merledu/azadi-soc/verif/random_tests/asm/extras/README.md

These tests were run on the core while simulating Azadi SoC's powered netlist
