merledu/azadi-soc/(threads)

Thread 3 (2021-09-10):

More multiple conflicting drivers

zainrizwankhan, 2021-09-10:
Continuing from #1 the signal `fp_dst_fmt_o` has been assigned a value here as well as in an `always_comb` block further down the code. This gives the following error, again, on Xcelium.

```
xmelab: *E,MULDRN (/home/zrkhan/Desktop/uvm-runs/azadi-new/hw/vendor/lowrisc_ibex/rtl/ibex_core.sv,860|13): Variable 'core_ibex_tb_top.dut.u_ibex_core.fp_load' has multiple conflicting drivers and the indicated output port connection in scope 'core_ibex_tb_top.dut.u_ibex_core' is contributing to this conflict set.
  assign fp_dst_fmt_o = FP32;
                      |
```

Closed 2021-09-10.
