merledu/azadi-soc/(list of files, drawings)

Other design files:
flash_model/N25Q128A13E_VG12/sim/waves.shm/waves.dsn
