merledu/azadi-soc/sub/rv_plic/src/rv_plic_reg_top.sv

// Copyright lowRISC contributors.
// Licensed under the Apache License, Version 2.0, see LICENSE for details.
// SPDX-License-Identifier: Apache-2.0
//
// Modified by MERL, for Azadi SoC

module rv_plic_reg_top import rv_plic_reg_pkg::*; (
  input logic clk_i,
  input logic rst_ni,

  // Below Regster interface can be changed
  input  tlul_pkg::tlul_h2d_t tl_i,
  output tlul_pkg::tlul_d2h_t tl_o,
  // To HW
  output rv_plic_reg_pkg::rv_plic_reg2hw_t reg2hw, // Write
  input  rv_plic_reg_pkg::rv_plic_hw2reg_t hw2reg, // Read

  // Config
  input devmode_i // If 1, explicit error return for unmapped register access
);

  localparam int AW = 10;
  localparam int DW = 32;
  localparam int DBW = DW/8; // Byte Width

  // register signals
  logic           reg_we;
  logic           reg_re;
  logic [AW-1:0]  reg_addr;
  logic [DW-1:0]  reg_wdata;
  logic [DBW-1:0] reg_be;
  logic [DW-1:0]  reg_rdata;
  logic           reg_error;

  logic           addrmiss, wr_err;

  logic [DW-1:0]  reg_rdata_next;

  tlul_pkg::tlul_h2d_t tl_reg_h2d;
  tlul_pkg::tlul_d2h_t tl_reg_d2h;

  assign tl_reg_h2d = tl_i;
  assign tl_o       = tl_reg_d2h;

  tlul_adapter_reg #(
    .RegAw(AW),
    .RegDw(DW)
  ) u_reg_if (
    .clk_i,
    .rst_ni,

    .tl_i (tl_reg_h2d),
    .tl_o (tl_reg_d2h),

    .we_o    (reg_we),
    .re_o    (reg_re),
    .addr_o  (reg_addr),
    .wdata_o (reg_wdata),
    .be_o    (reg_be),
    .rdata_i (reg_rdata),
    .error_i (reg_error)
  );

  assign reg_rdata = reg_rdata_next ;
  assign reg_error = (devmode_i & addrmiss) | wr_err ;

  // Define SW related signals
  // Format: <reg>_<field>_{wd|we|qs}
  //        or <reg>_{wd|we|qs} if field == 1 or 0
  logic ip_0_p_0_qs;
  logic ip_0_p_1_qs;
  logic ip_0_p_2_qs;
  logic ip_0_p_3_qs;
  logic ip_0_p_4_qs;
  logic ip_0_p_5_qs;
  logic ip_0_p_6_qs;
  logic ip_0_p_7_qs;
  logic ip_0_p_8_qs;
  logic ip_0_p_9_qs;
  logic ip_0_p_10_qs;
  logic ip_0_p_11_qs;
  logic ip_0_p_12_qs;
  logic ip_0_p_13_qs;
  logic ip_0_p_14_qs;
  logic ip_0_p_15_qs;
  logic ip_0_p_16_qs;
  logic ip_0_p_17_qs;
  logic ip_0_p_18_qs;
  logic ip_0_p_19_qs;
  logic ip_0_p_20_qs;
  logic ip_0_p_21_qs;
  logic ip_0_p_22_qs;
  logic ip_0_p_23_qs;
  logic ip_0_p_24_qs;
  logic ip_0_p_25_qs;
  logic ip_0_p_26_qs;
  logic ip_0_p_27_qs;
  logic ip_0_p_28_qs;
  logic ip_0_p_29_qs;
  logic ip_0_p_30_qs;
  logic ip_0_p_31_qs;
  logic ip_1_p_32_qs;
  logic ip_1_p_33_qs;
  logic ip_1_p_34_qs;
  logic ip_1_p_35_qs;
  logic ip_1_p_36_qs;
  logic ip_1_p_37_qs;
  logic ip_1_p_38_qs;
  logic ip_1_p_39_qs;
  logic ip_1_p_40_qs;
  logic ip_1_p_41_qs;
  logic ip_1_p_42_qs;
  logic ip_1_p_43_qs;
  logic ip_1_p_44_qs;
  logic ip_1_p_45_qs;
  logic ip_1_p_46_qs;
  logic ip_1_p_47_qs;
  logic ip_1_p_48_qs;

  logic le_0_le_0_qs;
  logic le_0_le_0_wd;
  logic le_0_le_0_we;
  logic le_0_le_1_qs;
  logic le_0_le_1_wd;
  logic le_0_le_1_we;
  logic le_0_le_2_qs;
  logic le_0_le_2_wd;
  logic le_0_le_2_we;
  logic le_0_le_3_qs;
  logic le_0_le_3_wd;
  logic le_0_le_3_we;
  logic le_0_le_4_qs;
  logic le_0_le_4_wd;
  logic le_0_le_4_we;
  logic le_0_le_5_qs;
  logic le_0_le_5_wd;
  logic le_0_le_5_we;
  logic le_0_le_6_qs;
  logic le_0_le_6_wd;
  logic le_0_le_6_we;
  logic le_0_le_7_qs;
  logic le_0_le_7_wd;
  logic le_0_le_7_we;
  logic le_0_le_8_qs;
  logic le_0_le_8_wd;
  logic le_0_le_8_we;
  logic le_0_le_9_qs;
  logic le_0_le_9_wd;
  logic le_0_le_9_we;
  logic le_0_le_10_qs;
  logic le_0_le_10_wd;
  logic le_0_le_10_we;
  logic le_0_le_11_qs;
  logic le_0_le_11_wd;
  logic le_0_le_11_we;
  logic le_0_le_12_qs;
  logic le_0_le_12_wd;
  logic le_0_le_12_we;
  logic le_0_le_13_qs;
  logic le_0_le_13_wd;
  logic le_0_le_13_we;
  logic le_0_le_14_qs;
  logic le_0_le_14_wd;
  logic le_0_le_14_we;
  logic le_0_le_15_qs;
  logic le_0_le_15_wd;
  logic le_0_le_15_we;
  logic le_0_le_16_qs;
  logic le_0_le_16_wd;
  logic le_0_le_16_we;
  logic le_0_le_17_qs;
  logic le_0_le_17_wd;
  logic le_0_le_17_we;
  logic le_0_le_18_qs;
  logic le_0_le_18_wd;
  logic le_0_le_18_we;
  logic le_0_le_19_qs;
  logic le_0_le_19_wd;
  logic le_0_le_19_we;
  logic le_0_le_20_qs;
  logic le_0_le_20_wd;
  logic le_0_le_20_we;
  logic le_0_le_21_qs;
  logic le_0_le_21_wd;
  logic le_0_le_21_we;
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
    .clk_i   (clk_i   ),
    .rst_ni  (rst_ni  ),

    // from register interface
    .we     (ie0_1_e_44_we),
    .wd     (ie0_1_e_44_wd),

    // from internal hardware
    .de     (1'b0),
    .d      ('0  ),

    // to internal hardware
    .qe     (),
    .q      (reg2hw.ie0[44].q ),

    // to register interface (read)
    .qs     (ie0_1_e_44_qs)
  );

  prim_subreg #(
    .DW      (1),
    .SWACCESS("RW"),
    .RESVAL  (1'h0)
  ) u_ie0_1_e_45 (
    .clk_i   (clk_i   ),
    .rst_ni  (rst_ni  ),

    // from register interface
    .we     (ie0_1_e_45_we),
    .wd     (ie0_1_e_45_wd),

    // from internal hardware
    .de     (1'b0),
    .d      ('0  ),

    // to internal hardware
    .qe     (),
    .q      (reg2hw.ie0[45].q ),

    // to register interface (read)
    .qs     (ie0_1_e_45_qs)
  );

  prim_subreg #(
    .DW      (1),
    .SWACCESS("RW"),
    .RESVAL  (1'h0)
  ) u_ie0_1_e_46 (
    .clk_i   (clk_i   ),
    .rst_ni  (rst_ni  ),

    // from register interface
    .we     (ie0_1_e_46_we),
    .wd     (ie0_1_e_46_wd),

    // from internal hardware
    .de     (1'b0),
    .d      ('0  ),

    // to internal hardware
    .qe     (),
    .q      (reg2hw.ie0[46].q ),

    // to register interface (read)
    .qs     (ie0_1_e_46_qs)
  );

  prim_subreg #(
    .DW      (1),
    .SWACCESS("RW"),
    .RESVAL  (1'h0)
  ) u_ie0_1_e_47 (
    .clk_i   (clk_i   ),
    .rst_ni  (rst_ni  ),

    // from register interface
    .we     (ie0_1_e_47_we),
    .wd     (ie0_1_e_47_wd),

    // from internal hardware
    .de     (1'b0),
    .d      ('0  ),

    // to internal hardware
    .qe     (),
    .q      (reg2hw.ie0[47].q ),

    // to register interface (read)
    .qs     (ie0_1_e_47_qs)
  );

  prim_subreg #(
    .DW      (1),
    .SWACCESS("RW"),
    .RESVAL  (1'h0)
  ) u_ie0_1_e_48 (
    .clk_i   (clk_i   ),
    .rst_ni  (rst_ni  ),

    // from register interface
    .we     (ie0_1_e_48_we),
    .wd     (ie0_1_e_48_wd),

    // from internal hardware
    .de     (1'b0),
    .d      ('0  ),

    // to internal hardware
    .qe     (),
    .q      (reg2hw.ie0[48].q ),

    // to register interface (read)
    .qs     (ie0_1_e_48_qs)
  );

  // R[threshold0]: V(False)
  prim_subreg #(
    .DW      (2),
    .SWACCESS("RW"),
    .RESVAL  (2'h0)
  ) u_threshold0 (
    .clk_i   (clk_i   ),
    .rst_ni  (rst_ni  ),

    // from register interface
    .we     (threshold0_we),
    .wd     (threshold0_wd),

    // from internal hardware
    .de     (1'b0),
    .d      ('0  ),

    // to internal hardware
    .qe     (),
    .q      (reg2hw.threshold0.q ),

    // to register interface (read)
    .qs     (threshold0_qs)
  );

  // R[cc0]: V(True)
  prim_subreg_ext #(
    .DW    (6)
  ) u_cc0 (
    .re     (cc0_re),
    .we     (cc0_we),
    .wd     (cc0_wd),
    .d      (hw2reg.cc0.d),
    .qre    (reg2hw.cc0.re),
    .qe     (reg2hw.cc0.qe),
    .q      (reg2hw.cc0.q ),
    .qs     (cc0_qs)
  );

  // R[msip0]: V(False)
  prim_subreg #(
    .DW      (1),
    .SWACCESS("RW"),
    .RESVAL  (1'h0)
  ) u_msip0 (
    .clk_i   (clk_i    ),
    .rst_ni  (rst_ni  ),

    // from register interface
    .we     (msip0_we),
    .wd     (msip0_wd),

    // from internal hardware
    .de     (1'b0),
    .d      ('0  ),

    // to internal hardware
    .qe     (),
    .q      (reg2hw.msip0.q ),

    // to register interface (read)
    .qs     (msip0_qs)
  );

  logic [57:0] addr_hit;
  always_comb begin
    addr_hit = '0;
    addr_hit[  0] = (reg_addr == RV_PLIC_IP_0_OFFSET);
    addr_hit[  1] = (reg_addr == RV_PLIC_IP_1_OFFSET);
    addr_hit[  2] = (reg_addr == RV_PLIC_LE_0_OFFSET);
    addr_hit[  3] = (reg_addr == RV_PLIC_LE_1_OFFSET);
    addr_hit[  4] = (reg_addr == RV_PLIC_PRIO0_OFFSET);
    addr_hit[  5] = (reg_addr == RV_PLIC_PRIO1_OFFSET);
    addr_hit[  6] = (reg_addr == RV_PLIC_PRIO2_OFFSET);
    addr_hit[  7] = (reg_addr == RV_PLIC_PRIO3_OFFSET);
    addr_hit[  8] = (reg_addr == RV_PLIC_PRIO4_OFFSET);
    addr_hit[  9] = (reg_addr == RV_PLIC_PRIO5_OFFSET);
    addr_hit[ 10] = (reg_addr == RV_PLIC_PRIO6_OFFSET);
    addr_hit[ 11] = (reg_addr == RV_PLIC_PRIO7_OFFSET);
    addr_hit[ 12] = (reg_addr == RV_PLIC_PRIO8_OFFSET);
    addr_hit[ 13] = (reg_addr == RV_PLIC_PRIO9_OFFSET);
    addr_hit[ 14] = (reg_addr == RV_PLIC_PRIO10_OFFSET);
    addr_hit[ 15] = (reg_addr == RV_PLIC_PRIO11_OFFSET);
    addr_hit[ 16] = (reg_addr == RV_PLIC_PRIO12_OFFSET);
    addr_hit[ 17] = (reg_addr == RV_PLIC_PRIO13_OFFSET);
    addr_hit[ 18] = (reg_addr == RV_PLIC_PRIO14_OFFSET);
    addr_hit[ 19] = (reg_addr == RV_PLIC_PRIO15_OFFSET);
    addr_hit[ 20] = (reg_addr == RV_PLIC_PRIO16_OFFSET);
    addr_hit[ 21] = (reg_addr == RV_PLIC_PRIO17_OFFSET);
    addr_hit[ 22] = (reg_addr == RV_PLIC_PRIO18_OFFSET);
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
  assign ie0_0_e_26_we = addr_hit[53] & reg_we & ~wr_err;
  assign ie0_0_e_26_wd = reg_wdata[26];

  assign ie0_0_e_27_we = addr_hit[53] & reg_we & ~wr_err;
  assign ie0_0_e_27_wd = reg_wdata[27];

  assign ie0_0_e_28_we = addr_hit[53] & reg_we & ~wr_err;
  assign ie0_0_e_28_wd = reg_wdata[28];
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
