merledu/azadi-soc/sub/uart/src/uart_buff_ctrl.sv

module buffer_control #(
  parameter int BUFFER_DEPTH = 128,
  parameter int BUFFER_WIDTH = 8,
  parameter int ADDR_WIDTH   = 8
)(
  input logic clk_i,
  input logic rst_ni,
  
  input logic re_i,
  input logic we_i,
  input logic clr_i,
  input logic rst_i, 
  input logic [BUFFER_WIDTH-1:0] wdata_i,
  
  output logic buffer_full,
  output logic [BUFFER_WIDTH:0] rdata_o,
  output logic                  buffer_empty,
  output logic [ADDR_WIDTH-1:0] bsize_o
);
  
  logic [ADDR_WIDTH:0] raddr;
  logic [ADDR_WIDTH:0] waddr;
  logic msb_comp;
  logic pointer_equal;
  logic fifo_web;
  logic fifo_cen;
  logic [6:0] fifo_addr;
  logic [8:0] rdata;
  
  // write address
  always_ff @ (posedge clk_i or negedge rst_ni) begin
    if(~rst_ni) begin
      waddr <= '0;
    end else begin
      if(clr_i) begin
	      waddr <= '0;
      end else if(we_i && ~buffer_full) begin
	      waddr <= waddr + 1;
      end
    end
   end

  // read adderss
  always_ff @ (posedge clk_i or negedge rst_ni) begin
    if(!rst_ni) begin
      raddr <= '0;
    end else begin 
      if(clr_i) begin
	      raddr <= '0;
      end else if (re_i & (~buffer_empty)) begin
	      raddr <= raddr + 1;
      end
    end
  end

  always_ff @ (posedge clk_i or negedge rst_ni) begin
    if(!rst_ni) begin
      buffer_full <= 1'b0;
    end else begin 
      if(clr_i) begin
	      buffer_full <= 1'b0;
      end else if((waddr >= 8'h7f) & we_i) begin
	      buffer_full <= 1'b1;
      end else if(raddr > 8'h00) begin
	      buffer_full <= 1'b0;
      end
    end
  end
  
  always_ff @ (posedge clk_i or negedge rst_ni) begin
    if(!rst_ni) begin
      buffer_empty <= 1'b0;
    end else begin
      if(clr_i) begin
	      buffer_empty <= 1'b0;
      end else if((raddr >= 8'h7f) & re_i) begin
	      buffer_empty <= 1'b1;
      end 
    end
  end

 sram_fifo fifo(
  .Q	  (rdata), 
  .CLK	(clk_i), 
  .CEN	(fifo_cen), 
  .WEN	(fifo_web), 
  .A	  (fifo_addr), 
  .D	  ({wdata_i, 1'b1}),
  .EMA	('0), 
  .RETN	('1)
 );

  assign fifo_web  = ((re_i && (~buffer_empty)) ? 1'b1 : (we_i && (~buffer_full)) ? 1'b0 : 1'b0 );
  assign fifo_addr = ({7{re_i}} & raddr) | ({7{we_i}} & waddr[6:0]);
  assign fifo_cen  = (we_i ? 1'b0 : re_i ? 1'b0 : 1'b1);
  assign rdata_o   = (raddr <= 8'h7f) ? rdata : '0 ;
  assign bsize_o   =  waddr;
  
endmodule 
