merledu/azadi-soc/sub/uart/src/uart_top.sv

// Copyright lowRISC contributors.
// Licensed under the Apache License, Version 2.0, see LICENSE for details.
// SPDX-License-Identifier: Apache-2.0
//
// Description: UART top level wrapper file

// `include "prim_assert.sv"

module uart_top (
    input logic clk_i,
    input logic rst_ni,

  // Bus Interface
    input  tlul_pkg::tlul_h2d_t tl_i,
    output tlul_pkg::tlul_d2h_t tl_o,
   
    output logic tx_o,
    output logic tx_oe,
    input  logic rx_i,
    
    output logic intr_tx,
    output logic intr_rx
);
    
    logic [31:0] wdata;
    logic [7:0] addr;
    logic        we;
    logic        re;
    logic [31:0] rdata;
    logic [3:0]  be;
    
uart_core u_uart_core(
    .clk_i   (clk_i),
    .rst_ni  (rst_ni),
    
    .ren     (re),
    .we      (we),
    .wdata   (wdata),
    .rdata   (rdata),
    .addr    (addr),    
    .tx_o    (tx_o),
    .tx_oe   (tx_oe),
    .rx_i    (rx_i),
    
    .intr_tx (intr_tx),
    .intr_rx (intr_rx)
);

    
 tlul_adapter_reg #(
    .RegAw(8),
    .RegDw(32)
 ) u_reg_if (
   .clk_i,
   .rst_ni,
    
   .tl_i (tl_i),
   .tl_o (tl_o),
    
   .we_o    (we),
   .re_o    (re),
   .addr_o  (addr),
   .wdata_o (wdata),
   .be_o    (be),
   .rdata_i (rdata),
   .error_i (1'b0)
);
endmodule
