merledu/azadi-soc/flash_model/N25Q128A13E_VG12/code/N25Qxxx.v

//-MICRON--MICRON--MICRON--MICRON--MICRON--MICRON--MICRON--MICRON--MICRON--MICRON--MICRON-
//-MICRON--MICRON--MICRON--MICRON--MICRON--MICRON--MICRON--MICRON--MICRON--MICRON--MICRON-
//-MICRON--MICRON--MICRON--MICRON--MICRON--MICRON--MICRON--MICRON--MICRON--MICRON--MICRON-
//
//  N25Qxxx
//
//  Verilog Behavioral Model
//  Version 1.2
//
//  Copyright (c) 2013 Micron Inc.
//
//-MICRON--MICRON--MICRON--MICRON--MICRON--MICRON--MICRON--MICRON--MICRON--MICRON--MICRON-
//-MICRON--MICRON--MICRON--MICRON--MICRON--MICRON--MICRON--MICRON--MICRON--MICRON--MICRON-
//-MICRON--MICRON--MICRON--MICRON--MICRON--MICRON--MICRON--MICRON--MICRON--MICRON--MICRON-
// Confidential:
// -------------
// This file and all files delivered herewith are Micron Confidential Information.
// 
// 
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
// Copyright 2013 Micron Technology, Inc. All rights reserved.
//
`timescale 1ns / 1ps

/*~~~~~~~~~~~~~~~~~~~~~~~~~~~~~~~~~~~~~~~~~~~~~~~~~~~~~~~~~
-----------------------------------------------------------
-----------------------------------------------------------
--                                                       --
--           TOP LEVEL MODULE                            --
--                                                       --
-----------------------------------------------------------
-----------------------------------------------------------
~~~~~~~~~~~~~~~~~~~~~~~~~~~~~~~~~~~~~~~~~~~~~~~~~~~~~~~~~*/



`include "include/UserData.h"

module paramConfig();
`include "include/DevParam.h"

endmodule


//***********************************************************************
//***********************************************************************
//    N25Q device as stand alone
//***********************************************************************
//***********************************************************************

`ifdef Feature_8
    `ifdef HOLD_pin
        module N25Qxxx (S, C_, HOLD_DQ3, DQ0, DQ1, Vcc, Vpp_W_DQ2, RESET2);
    `elsif RESET_pin 
        module N25Qxxx (S, C_, RESET_DQ3, DQ0, DQ1, Vcc, Vpp_W_DQ2, RESET2);
    `endif
`else    
    `ifdef HOLD_pin
        module N25Qxxx (S, C_, HOLD_DQ3, DQ0, DQ1, Vcc, Vpp_W_DQ2);
    `elsif RESET_pin 
        module N25Qxxx (S, C_, RESET_DQ3, DQ0, DQ1, Vcc, Vpp_W_DQ2);
    `endif
`endif

`include "include/DevParam.h"
 parameter [1:0] rdeasystacken = 0;
 parameter [1:0] rdeasystacken2 = 0;
 parameter [15:0] NVConfigReg_default = `NVCR_DEFAULT_VALUE;
 
`ifdef MEDITERANEO
    `define defaultDummy 6
    `define defaultiDummy 5
`else
    `define defaultDummy 8
    `define defaultiDummy 7
`endif    

input S;
input C_;
input [`VoltageRange] Vcc;

inout DQ0; 
inout DQ1;
//wire RESET;

`ifdef Feature_8
   `ifdef HOLD_pin
        inout HOLD_DQ3; //input HOLD, inout DQ3
        input RESET2;
    `elsif RESET_pin
        inout RESET_DQ3; //input HOLD, inout DQ3
        input RESET2;
    `endif
`else
   `ifdef HOLD_pin
        inout HOLD_DQ3; //input HOLD, inout DQ3
    `elsif RESET_pin
        inout RESET_DQ3; //input HOLD, inout DQ3
    `endif
`endif


inout Vpp_W_DQ2; //input Vpp_W, inout DQ2 (VPPH not implemented)


parameter [40*8:1] memory_file = "mem_Q128_bottom.vmf";

parameter [48*8:1] fdp_file = "sfdp.vmf";


reg PollingAccessOn = 0;
reg ReadAccessOn = 0;
wire WriteAccessOn; 

// indicate type of data that will be latched by the model:
//  C=command, A=address, I= address on two pins; E= address on four pins; D=data, N=none, Y=dummy, F=dual_input(F=fast),Q=Quad_io 
reg [8:1] latchingMode = "N";

reg [8*8:1] protocol="extended";

reg [cmdDim-1:0] cmd='h0;
`ifdef byte_4
  reg [addrDimLatch4-1:0] addrLatch='h0;
`else
  reg [addrDimLatch-1:0] addrLatch='h0;
`endif
reg [addrDim-1:0] addr='h0;
reg [dataDim-1:0] data='h0;
reg [dummyDim-1:0] dummy='h0;
reg [dataDim-1:0] LSdata='h0;
reg [dataDim-1:0] dataOut='h0;

integer dummyDimEff;

reg [40*8:1] cmdRecName;

reg quadMode ='h0;

reg die_active = 'h1;  // Indicates that this die is active
                       // Used for stacked die


buf (strong1, strong0) b0(C, C_);

//----------------------
// Report Model Info 
//----------------------
initial begin
    $display ("==============================================");
    $display ("===INFO=== Model Configuration Info");
    determineDevName;
    `ifdef RESET_pin
        $display ("===INFO=== DQ3 = RESET pin");
    `endif   
    `ifdef HOLD_pin
        $display ("===INFO=== DQ3 = HOLD pin");
    `endif   
    `ifdef XIP_Numonyx 
        $display ("===INFO=== XIP type = Numonyx");
    `endif   
    `ifdef XIP_basic 
        $display ("===INFO=== XIP type = Basic");
    `endif   
    `ifdef VCC_1e8V
        $display ("===INFO=== VCC 1.8V");
    `endif    
    `ifdef VCC_3V
        $display ("===INFO=== VCC 3V");
    `endif   
    $display ("==============================================");
end


//----------------------
// HOLD signal
//----------------------
//dovrebbe essere abilitato attraverso il bit 4 del VECR o anche attraverso il bit 4 del NVECR
reg NVCR_HoldResetEnable;

`ifdef HOLD_pin

    reg intHOLD=1;

//aggiunta verificare
   //latchingMode=="E"                                                                                                                                                                 
    assign HOLD = (read.enable_quad || 
                   quadMode == 1 || 
                   latchingMode=="Q"  || 
                   latchingMode=="E" || 
                   protocol=="quad" || 
                   VolatileEnhReg.VECR[4]==0 || 
                   (NVCR_HoldResetEnable==0 && prog.dummySetByVECR==0))  ? 1 : HOLD_DQ3; //serve per disabilitare la funzione di hold nel caso di quad read


    always @(HOLD) if (S==0 && C==0) 
        intHOLD = HOLD;
    
    always @(negedge C) if(S==0 && intHOLD!=HOLD) 
        intHOLD = HOLD;

    always @(posedge HOLD , posedge S) if(S==1)
        intHOLD = 1;
    
    always @intHOLD if (Vcc>=Vcc_min) begin
        if(intHOLD==0)
            $display("[%0t ns] ==INFO== Hold condition enabled: communication with the device has been paused.", $time);
        else if(intHOLD==1)
            $display("[%0t ns] ==INFO== Hold condition disabled: communication with the device has been activated.", $time);  
   end
`endif



//-------------------------
// Internal signals
//-------------------------

reg busy=0;

reg [2:0] ck_count = 0; //clock counter (modulo 8) 

reg reset_by_powerOn = 1; //reset_by_powerOn is updated in "Power Up & Voltage check" section


`ifdef Feature_8
        assign RESET = ((read.enable_quad || latchingMode=="Q" || quadMode == 1 ||
                        cmdRecName=="Quad Output Read" || cmdRecName=="Quad I/O Fast Read" ||
                        latchingMode=="E" || protocol=="quad" || VolatileEnhReg.VECR[4]==0 ||
                        NVCR_HoldResetEnable==0 || cmdRecName=="Extended command DOFRDTR" || 
                        cmdRecName=="Extended command DIOFRDTR" || cmdRecName=="Extended command QOFRDTR" ||
                        cmdRecName=="Extended command QIOFRDTR" || cmdRecName=="Quad Command Fast Read" ||
                        cmdRecName=="Quad Output Read" || cmdRecName=="Quad I/O Fast Read" ) &&  S == 0)? 1 : RESET2;  //|| cmdRecName=="Quad I/O Fast Read")  ? 1 : RESET_DQ3; //serve per disabilitare la funzione di reset nel caso di quad read

        assign int_reset = (RESET===0 || RESET===1 && protocol!="quad") ? !RESET || reset_by_powerOn : reset_by_powerOn;

    `ifdef HOLD_pin
        assign logicOn = !int_reset && !S && intHOLD; 
    `else
        assign logicOn = !int_reset && !S;
    `endif  
`else    
    `ifdef RESET_pin

        assign RESET = (read.enable_quad || latchingMode=="Q" || quadMode == 1 ||
                        cmdRecName=="Quad Output Read" || cmdRecName=="Quad I/O Fast Read" ||
                        latchingMode=="E" || protocol=="quad" || VolatileEnhReg.VECR[4]==0 ||
                        NVCR_HoldResetEnable==0 || cmdRecName=="Extended command DOFRDTR" || 
                        cmdRecName=="Extended command DIOFRDTR" || cmdRecName=="Extended command QOFRDTR" ||
                        cmdRecName=="Extended command QIOFRDTR" || cmdRecName=="Quad Command Fast Read" ||
                        //cmdRecName=="Quad Output Read" || cmdRecName=="Quad I/O Fast Read" ) &&  S == 0)? 1 : RESET_DQ3;  //|| cmdRecName=="Quad I/O Fast Read")  ? 1 : RESET_DQ3; //serve per disabilitare la funzione di reset nel caso di quad read
                        cmdRecName=="Quad Output Read" || cmdRecName=="Quad I/O Fast Read" )? 1 : RESET_DQ3;  //|| cmdRecName=="Quad I/O Fast Read")  ? 1 : RESET_DQ3; //serve per disabilitare la funzione di reset nel caso di quad read

        assign int_reset = (RESET===0 || (RESET===1 && protocol!="quad")) ? !RESET || reset_by_powerOn : reset_by_powerOn;

    `else
        assign int_reset = reset_by_powerOn;
    `endif  

    `ifdef HOLD_pin
        assign logicOn = !int_reset && !S && intHOLD; 
    `else
        assign logicOn = !int_reset && !S;
    `endif  
`endif  



reg deep_power_down = 0; //updated in "Deep power down" processes

//XIP mode status (XIP=0 XIP mode not selected, XIP=1 XIP mode selected)
reg XIP=0; 
// driven high on XIP_reset sequence, this is the first part of PLRS
reg XIP_rst = 0; 
// driven high on Power reset sequence this is the second part of PLRS
reg power_rst = 0; 
// Power Loss Recovery Sequence required flag 
reg plrs_required = 0; 


reg DoubleTransferRate = 0;
wire read_enable = read.enable || 
                   read.enable_dual || 
                   read.enable_quad || 
                   read.enable_fast || 
                   VolatileReg.enable_VCR_read || 
                   VolatileEnhReg.enable_VECR_read ||
                   stat.enable_SR_read ||
                   PMReg.enable_PMR_read ||
                   `ifdef byte_4
                   ExtAddReg.enable_EAR_read ||
                   `endif
                   `ifdef MEDITERANEO
                   ASP_Reg.enable_ASP_read ||
                   PSWORD_Reg.enable_PSWORD_read || //Nov13
                   ppb.enable_PPBReg_read ||
                   plb.enable_PLBReg_read ||
                   lock.enable_lockReg_read ||
                   lock4kb.enable_lockReg_read ||
                   `endif
                   NonVolatileReg.enable_NVCR_read ||
                   read.enable_ID; 
                

//---------------------------------------
//  Vpp_W signal : write protect feature
//---------------------------------------

assign W_int = Vpp_W_DQ2;

//----------------------------
// CUI decoders istantiation
//----------------------------

`include "include/Decoders.h"




//---------------------------
// Modules instantiations
//---------------------------

Memory          mem (memory_file);

UtilFunctions   f ();

`ifdef MEDT_GPRR
GeneralPurposeRegister GPRR_Reg ();
`endif

Program         prog ();

StatusRegister  stat ();

FlagStatusRegister flag ();

NonVolatileConfigurationRegister  NonVolatileReg (NVConfigReg_default);

VolatileEnhancedConfigurationRegister VolatileEnhReg ();

VolatileConfigurationRegister VolatileReg ();

`ifdef byte_4

    ExtendedAddressRegister ExtAddReg ();

`endif

FlashDiscoveryParameter FlashDiscPar (fdp_file);

Read            read ();        

LockManager     lock (); //DYB

`ifdef MEDT_4KBLocking
    LockManager4KB  lock4kb();
`endif

`ifdef MEDT_PPB
    PPBManager ppb();
    PPBLockBitRegister plb();
`endif

`ifdef MEDT_PASSWORD
    PasswordRegister PSWORD_Reg();
`endif

`ifdef MEDT_ADVANCED_SECTOR
    ASPRegister ASP_Reg();
`endif

ProtectionManagementRegister PMReg(); // instantiated the protection management register -- 

`ifdef timingChecks
 
    `ifdef N25Q256A33E 
        TimingCheck     timeCheck (S, C, DQ0, DQ1, W_int, RESET);
    `elsif  N25Q256A31E 
        TimingCheck     timeCheck (S, C, DQ0, DQ1, W_int, RESET);
    `elsif  N25Q256A13E
        TimingCheck     timeCheck (S, C, DQ0, DQ1, W_int, HOLD_DQ3);
    `elsif  N25Q256A11E
        TimingCheck     timeCheck (S, C, DQ0, DQ1, W_int, HOLD_DQ3);
    `elsif  N25Q064A13E
        TimingCheck     timeCheck (S, C, DQ0, DQ1, W_int, HOLD_DQ3);
    `elsif  N25Q064B11E
        TimingCheck     timeCheck (S, C, DQ0, DQ1, W_int, HOLD_DQ3);
    `elsif  N25Q064B13E
        TimingCheck     timeCheck (S, C, DQ0, DQ1, W_int, HOLD_DQ3);
    `elsif  N25Q064B31E
        TimingCheck     timeCheck (S, C, DQ0, DQ1, W_int, RESET);
    `elsif  N25Q064B33E
        TimingCheck     timeCheck (S, C, DQ0, DQ1, W_int, RESET);
    `elsif N25Q064A11E
        TimingCheck     timeCheck (S, C, DQ0, DQ1, W_int, HOLD_DQ3);
    `elsif N25W064A11E
        TimingCheck     timeCheck (S, C, DQ0, DQ1, W_int, HOLD_DQ3);
    `elsif  N25Q032A13E
        TimingCheck     timeCheck (S, C, DQ0, DQ1, W_int, HOLD_DQ3);
    `elsif N25Q032A11E
        TimingCheck     timeCheck (S, C, DQ0, DQ1, W_int, HOLD_DQ3);
    `elsif MEDITERANEO_1_8v    
        TimingCheck     timeCheck (S, C, DQ0, DQ1, W_int, HOLD_DQ3);
    `elsif MEDITERANEO    
        TimingCheck     timeCheck (S, C, DQ0, DQ1, W_int, HOLD_DQ3);
    `elsif N25Q256A83E    
        TimingCheck     timeCheck (S, C, DQ0, DQ1, W_int, HOLD_DQ3);
    `elsif N25Q256A73E    
        TimingCheck     timeCheck (S, C, DQ0, DQ1, W_int, HOLD_DQ3);
    `elsif N25Q128A11E
        TimingCheck     timeCheck (S, C, DQ0, DQ1, W_int, HOLD_DQ3);
    `elsif N25Q128A11B
        TimingCheck     timeCheck (S, C, DQ0, DQ1, W_int, HOLD_DQ3);
    `elsif N25W128A11E
        TimingCheck     timeCheck (S, C, DQ0, DQ1, W_int, HOLD_DQ3);
    `elsif N25W128A11B
        TimingCheck     timeCheck (S, C, DQ0, DQ1, W_int, HOLD_DQ3);
    `elsif N25Q128A13E
        TimingCheck     timeCheck (S, C, DQ0, DQ1, W_int, HOLD_DQ3);
    `elsif N25Q128A13B
        TimingCheck     timeCheck (S, C, DQ0, DQ1, W_int, HOLD_DQ3);
    `elsif N25Q016A11E
        TimingCheck     timeCheck (S, C, DQ0, DQ1, W_int, HOLD_DQ3);
    `elsif N25Q016A13E
        TimingCheck     timeCheck (S, C, DQ0, DQ1, W_int, HOLD_DQ3);
    `elsif N25Q008A11E
        TimingCheck     timeCheck (S, C, DQ0, DQ1, W_int, HOLD_DQ3);
    `endif

`endif  

`ifdef HOLD_pin

    DualQuadOps     dualQuad (S, C, ck_count,DoubleTransferRate, DQ0, DQ1, Vpp_W_DQ2, HOLD_DQ3); 

`elsif RESET_pin
 
    DualQuadOps     dualQuad (S, C, ck_count,DoubleTransferRate, DQ0, DQ1, Vpp_W_DQ2, RESET_DQ3); 
 
`endif

OTP_memory      OTP (); 


`include "include/PLRSDetectors.h"

DebugModule Debug ();


//----------------------------------
//  Signals for latching control
//----------------------------------
reg rescue_seq_flag = 0;
integer iCmd, iAddr, iData, iDummy, iXIP_count, iPow_res;
reg dtr_dout_started; // it is set after negedge C where 1st bit was outputted (used to prevent DUT from starting data output on posedge C)

always @(negedge S) begin : CP_latchInit

    disable VolatileReg.READ_VCR;//test Jan17

    if (!XIP) latchingMode = "C";  
    
    ck_count = 0;
    iCmd = cmdDim - 1;
    addrLatch = 'h0;  //etv
    `ifdef byte_4
    //if (prog.enable_4Byte_address || cmd=='h0E || cmd=='hBE || cmd=='hEE) 
    if (prog.enable_4Byte_address || cmd=='h0E || cmd=='hE3) 
        iAddr = addrDimLatch4 - 1;
    else 
        iAddr = addrDimLatch - 1;
    `else
    if (cmd=='hE2)
        iAddr = addrDimLatch4 - 1;
    else
     iAddr = addrDimLatch - 1; 
    `endif
    iData = dataDim - 1;

    iDummy = dummyDimEff - 1;
    dtr_dout_started = 0;   //DTR
end


always @(posedge C) if(logicOn) begin
    ck_count <= ck_count + 1;

end

always @(posedge read_enable) begin
  ck_count = 0;
end


//-------------------------
// Latching commands
//-------------------------


event cmdLatched;


always @(C) if(logicOn && latchingMode=="C" && protocol=="extended") begin : CP_latchCmd
  `ifdef MEDITERANEO
  if (((C==0) && (VolatileEnhReg.VECR[5] == 0) && (iCmd != 7)) || (C == 1)) begin 
  `else
  if (C==1) begin  
  `endif
    cmd[iCmd] = DQ0;

    if (iCmd>0)
        iCmd = iCmd - 1;
    else if(iCmd==0) begin
        latchingMode = "N";
        `ifdef MEDITERANEO
            if (prog.enable_4Byte_address || cmd=='h0E || cmd=='hE3 || cmd=='hE2) 
                iAddr = addrDimLatch4 - 1;
            else 
                iAddr = addrDimLatch - 1;
        `endif
        -> cmdLatched;
    end    
 end        
end

always @(C) if(logicOn && latchingMode=="C" && protocol=="dual") begin : CP_latchCmdDual
      `ifdef MEDITERANEO
   if (((C==0) && (VolatileEnhReg.VECR[5] == 0) && (iCmd != 7)) || (C == 1)) begin 
   `else
  if (C==1) begin  
   `endif

    cmd[iCmd] = DQ1;
    cmd[iCmd-1] = DQ0;

    if (iCmd>=3)
        iCmd = iCmd - 2;
    else if(iCmd==1) begin
        latchingMode = "N";
        `ifdef MEDITERANEO
            if (prog.enable_4Byte_address || cmd=='h0E || cmd=='hE3 || cmd=='hE2) 
                iAddr = addrDimLatch4 - 1;
            else 
                iAddr = addrDimLatch - 1;
        `endif
        -> cmdLatched;
         end
     //end     
  end       
end


`ifdef HOLD_pin
always @(C) if(logicOn && latchingMode=="C" && protocol=="quad") begin : CP_latchCmdQuad
  `ifdef MEDITERANEO
  if (((C==0) && (VolatileEnhReg.VECR[5] == 0) && (iCmd != 7)) || (C == 1)) begin 
  `else
  if (C==1) begin  
  `endif
    cmd[iCmd] = HOLD_DQ3;
    cmd[iCmd-1] = Vpp_W_DQ2;
    cmd[iCmd-2] = DQ1;
    cmd[iCmd-3] = DQ0;

    if (iCmd>=7)
        iCmd = iCmd - 4;
    else if(iCmd==3) begin
        latchingMode = "N";
        `ifdef MEDITERANEO
            if (prog.enable_4Byte_address || cmd=='h0E || cmd=='hE3 || cmd=='hE2) 
                iAddr = addrDimLatch4 - 1;
            else 
                iAddr = addrDimLatch - 1;
        `endif
        -> cmdLatched;
    end    
  end      
end

`elsif RESET_pin

always @(C) if(logicOn && latchingMode=="C" && protocol=="quad") begin : CP_latchCmdQuad
  if (C==1) begin 
  // if (((C==0) && (VolatileEnhReg.VECR[5] == 0) && (iCmd != 7)) || (C == 1)) begin 

    cmd[iCmd] = RESET_DQ3;
    cmd[iCmd-1] = Vpp_W_DQ2;
    cmd[iCmd-2] = DQ1;
    cmd[iCmd-3] = DQ0;

    if (iCmd>=7)
        iCmd = iCmd - 4;
    else if(iCmd==3) begin
        latchingMode = "N";
        -> cmdLatched;
    end    
  end        
end

`endif
//-------------------------
// Latching address
//-------------------------


event addrLatched;


always @(C) if (logicOn && latchingMode=="A") begin : CP_latchAddr
  if (C==1 || DoubleTransferRate==1 || 
    (C==0 && (cmd=='h0D || cmd=='h3D || cmd=='hBD || cmd=='h6D || cmd=='hED || cmd=='h0E || cmd=='h39 || cmd=='hBE || cmd=='h3A || cmd=='hEE)
    // (C==0 && (cmd=='h0D || cmd=='h3D || cmd=='hBD || cmd=='h6D || cmd=='hED || cmd=='h0E || cmd=='h3E || cmd=='hBE || cmd=='h6E || cmd=='hEE)
    && iAddr!=23 && iAddr!=31)) begin // ENABLE if posedge C in all modes or negedge C in DTR mode, except for negedge C immediately following negedge S in XIP mode and also in negedge of DTR mode and when the command is (address and data in DTR mode ('h0D,'h3D,'h6D) 

    addrLatch[iAddr] = DQ0;
    if (iAddr>0)
        iAddr = iAddr - 1;
    else if(iAddr==0) begin
        latchingMode = "N";
        `ifdef byte_4
        if ((!prog.enable_4Byte_address) && (cmd != 'h13) && (cmd != 'h0C) && (cmd != 'h3C) && (cmd != 'h6C) && (cmd != 'h0E) && (cmd != 'hE0) && (cmd !='h12) && (cmd != 'hE3) &&
             cmd != 'hE1 && cmd != 'hE2 )
            begin  
            addr = {ExtAddReg.EAR[EARvalidDim-1:0],addrLatch[addrDimLatch-1:0]};
            end
          //else if(prog.enable_4Byte_address==1) 
          else if(prog.enable_4Byte_address==1 || cmd != 'h13) 
            begin
                addr = addrLatch[addrDimLatch4-1:0];
            end
          else begin
              addr = addrLatch[addrDim-1:0];
              end
        `else
        addr = addrLatch[addrDim-1:0];
        `endif
        -> addrLatched;
    end
  end
end



always @(C) if (logicOn && latchingMode=="I") begin : CP_latchAddrDual
  if (C==1 ||DoubleTransferRate==1 || (C==0 && (cmd=='h0D || cmd=='h3D ||
    cmd=='hBD || cmd=='h0E || cmd=='h39 || cmd=='hBE) && iAddr!=23 && iAddr!=31)) begin // ENABLE if posedge C in all modes or negedge C in DTR mode, except for negedge C immediately follwing negedge S in XIP mode and also in negedge of DTR mode and when the command is (address and data in DTR mode ('hBD) 
    // cmd=='hBD || cmd=='h0E || cmd=='h3E || cmd=='hBE) && iAddr!=23 && iAddr!=31)) begin // ENABLE if posedge C in all modes or negedge C in DTR mode, except for negedge C immediately follwing negedge S in XIP mode and also in negedge of DTR mode and when the command is (address and data in DTR mode ('hBD) 

    addrLatch[iAddr] = DQ1;
    addrLatch[iAddr-1]= DQ0;
    if (iAddr>=3)
        iAddr = iAddr - 2;
    else if(iAddr==1) begin
        latchingMode = "N";
        `ifdef byte_4
            if (!prog.enable_4Byte_address && (cmd != 'hBC && cmd != 'hBE && cmd != 'h3C && cmd != 'h0C && cmd != 'h0E)) begin 
                addr = {ExtAddReg.EAR[EARvalidDim-1:0],addrLatch[addrDimLatch-1:0]};
            end
            else addr = addrLatch[addrDimLatch4-1:0];
        `else
        addr = addrLatch[addrDim-1:0];
        `endif

        -> addrLatched;

    end
  end
end

`ifdef HOLD_pin
always @(C) if (logicOn && latchingMode=="E") begin : CP_latchAddrQuad
  if (C==1 ||DoubleTransferRate==1 || (C==0 && (cmd=='h0D || cmd=='h6D
    ||cmd=='hED || cmd=='h0E || cmd=='h3A ||cmd=='hEE) && iAddr!=23 && iAddr!=31)) begin // ENABLE if posedge C in all modes or negedge C in DTR mode, except for negedge C immediately following negedge S in XIP mode and also in negedge of DTR mode and when the command is (address and data in DTR mode ('hED)
    // ||cmd=='hED || cmd=='h0E || cmd=='h6E ||cmd=='hEE) && iAddr!=23 && iAddr!=31)) begin // ENABLE if posedge C in all modes or negedge C in DTR mode, except for negedge C immediately following negedge S in XIP mode and also in negedge of DTR mode and when the command is (address and data in DTR mode ('hED)

    addrLatch[iAddr] = HOLD_DQ3;
    addrLatch[iAddr-1]= Vpp_W_DQ2;
    addrLatch[iAddr-2]= DQ1;
    addrLatch[iAddr-3]= DQ0;
   
    if (iAddr>=7)
        iAddr = iAddr - 4;

    else if(iAddr==3) begin
        latchingMode = "N";
        `ifdef byte_4
            if (!prog.enable_4Byte_address && (cmd != 'hEC && cmd != 'hEE && cmd != 'h0E && cmd != 'h6C  && cmd != 'h0C  && cmd != 'hE0)) begin 
            addr = {ExtAddReg.EAR[EARvalidDim-1:0],addrLatch[addrDimLatch-1:0]};
                        end
            else begin
            addr = addrLatch[addrDimLatch4-1:0];
            end
        `else
        addr = addrLatch[addrDim-1:0];
        `endif


        -> addrLatched;
    end
  end
end

`elsif RESET_pin
always @(C) if (logicOn && latchingMode=="E") begin : CP_latchAddrQuad
  if (C==1 ||DoubleTransferRate==1 || (C==0 && (cmd=='h0D || cmd=='h6D ||cmd=='hED || cmd=='h0E || cmd=='h6E ||cmd=='hEE) && iAddr!=23 && iAddr!=31)) begin // ENABLE if posedge C in all modes or negedge C in DTR mode, except for negedge C immediately following negedge S in XIP mode

    addrLatch[iAddr] = RESET_DQ3;
    addrLatch[iAddr-1]= Vpp_W_DQ2;
    addrLatch[iAddr-2]= DQ1;
    addrLatch[iAddr-3]= DQ0;
   
    if (iAddr>=7)
        iAddr = iAddr - 4;

    else if(iAddr==3) begin
        latchingMode = "N";
        `ifdef byte_4
        if (!prog.enable_4Byte_address && (cmd != 'hEC)) 
            addr = {ExtAddReg.EAR[EARvalidDim-1:0],addrLatch[addrDimLatch-1:0]};
        else  
            addr = addrLatch[addrDim-1:0];
        `else
        addr = addrLatch[addrDim-1:0];
        `endif

        -> addrLatched;
    end
  end
end

`endif
//-----------------
// Latching data
//-----------------


event dataLatched;
reg dataLatchedr=0;

always @(C) if (logicOn && latchingMode=="D") begin : CP_latchData
    `ifdef MEDITERANEO
  if (((C==0) && (VolatileEnhReg.VECR[5] == 0)) || (C == 1)) begin 
  `else
  if (C==1) begin // ENABLE if posedge C in all modes 
  `endif
    data[iData] = DQ0;

    if (iData>0)begin
        iData = iData-1;
        prog.bitCounter=prog.bitCounter+1;
    end else begin
     if ((cmdRecName=="Write NV Configuration Reg" || cmdRecName=="ASP Write")&& prog.LSByte) begin
        LSdata=data;
         prog.LSByte=0;
     end   
        -> dataLatched;
        dataLatchedr=1;
        $display("  [%0t ns] Data latched: %h", $time, data);
        iData=dataDim-1;
    end    
  end
end






//-----------------
// Latching dummy
//-----------------


event dummyLatched;
event checkProtocol;
event checkProtocolAfterXIPexit;

always @(posedge C) if (logicOn && latchingMode=="Y") begin : CP_latchDummy
#0;
    dummy[iDummy] = DQ0;

    //XIP mode setting
`ifdef XIP_basic

    if(iDummy==dummyDimEff-1 &&  dummy[iDummy]==0) begin

        XIP=1;


    end else if (iDummy==dummyDimEff-1 &&  dummy[iDummy]==1) begin

        if (XIP) begin 
            $display("  [%0t ns] XIP mode exit.", $time);
            -> checkProtocolAfterXIPexit;
        end
    end

//!    end     

 `elsif XIP_Numonyx
 
    if(iDummy==dummyDimEff-1 &&  dummy[iDummy]==0 && VolatileReg.VCR[3]==0) begin
    
        XIP=1; 
       

    end else if (iDummy==dummyDimEff-1 &&  dummy[iDummy]==1) begin
       
        if (XIP) begin 
            $display("  [%0t ns] XIP mode exit.", $time);
            -> checkProtocolAfterXIPexit;
            VolatileReg.VCR[3] = 1;
        end

        XIP=0;
    end    

 `endif  

    if (iDummy>0) begin 
       // if(cmdRecName != "Read Serial Flash Discovery Parameter")
       //     begin
                iDummy = iDummy-1;
       //     end
        end  
        else begin
        -> dummyLatched;
        $display("  [%0t ns] Dummy clock cycles latched.", $time);
        iDummy=dummyDimEff-1;
        ck_count <= #1 0; // avoid race condition with ck_count auto-incrementer @(posedge C)
    end    

end

/////////////////////////////////////////////////////////////////////////////////////////////////////////////////////

event XIP_reset; // Activated XIP memory reset after a controller reset;

event power_reset; // rescue sequence during  power loss when attempting to write Non Volatile configuration Register
///////////////////////////////////////////////////////////////////////////////
// sequence to check for rescue sequence for XIP Memory reset;
///////////////////////////////////////////////////////////////////////////////

always @(power_reset) begin
    plrs_required = 1;
    XIP_rst = 1;
end

time S_high_plrs = 1000;
time S_low_plrs = 1000;
time delta_plrs = 0;

//---------------------------------------------------------------
always
    @S if(S==0) //posedge
    @S if(S==1)
    begin
        S_high_plrs = $time;
    end

always
    @S if(S==1) //negedge
    @S if(S==0)
    begin
        S_low_plrs = $time;
        delta_plrs = $time - S_high_plrs;
        if(rescue_seq_flag==1 && delta_plrs < 50) begin
            $display(" [%0t ps] ==TIMING ERROR== PLRS: tSHSL constraint violated during Power Loss Rescue Sequence ", $time);
        end
    end    
        
////////////////////////////////////////////////////////////////////////////////////////////////////////////////////////////////// 
 

// check dummy clock cycles 
`ifdef MEDT_DUMMY_CYCLES
time CDeltaBy2;
integer fO; //calculated operating frequency upon latching of dummy cycles
always @(dummyLatched) begin
    CDeltaBy2 = timeCheck.C_high - timeCheck.C_low;
    fO = 1000 / (CDeltaBy2 * 2);
    //$display("---fO--- %d @ %0t", fO, $time); 
    case (dummyDimEff)

        1: begin

            if(((fO>94) && (cmdRecName=="Read Fast")) || 
              ((fO>88) &&  (cmdRecName=="Dual Output Fast Read")) ||
              ((fO>60) && (cmdRecName=="Dual I/O Fast Read" || cmdRecName=="Dual Command Fast Read")) ||
              ((fO>69) && (cmdRecName=="Quad Output Fast Read")) ||
              ((fO>41) && (cmdRecName=="Quad I/O Fast Read" || cmdRecName=="Quad Command Fast Read")))
               $display("  [%0t ns]  ==WARNING== Dummy clock number is not sufficient for the operating frequency. The memory reads wrong data",$time);
        
           end

        2: begin

            if(((fO>112) && (cmdRecName=="Read Fast")) ||
              ((fO>97) && (cmdRecName=="Dual Output Fast Read")) ||
              ((fO>77) && (cmdRecName=="Dual I/O Fast Read" || cmdRecName=="Dual Command Fast Read")) ||
              ((fO>78) && (cmdRecName=="Quad Output Fast Read")) ||
              ((fO>50) && (cmdRecName=="Quad I/O Fast Read" || cmdRecName=="Quad Command Fast Read")))
               $display("  [%0t ns] ==WARNING== Dummy clock number is not sufficient for the operating frequency. The memory reads wrong data",$time);
        
           end

        3: begin
             
               if(((fO>129) && (cmdRecName=="Read Fast")) ||
                 ((fO>106) && (cmdRecName=="Dual Output Fast Read")) ||
                 ((fO>88) && (cmdRecName=="Dual I/O Fast Read" || cmdRecName=="Dual Command Fast Read")) || 
                 ((fO>88) && (cmdRecName=="Quad Output Fast Read")) ||
                 ((fO>60) && (cmdRecName=="Quad I/O Fast Read" || cmdRecName=="Quad Command Fast Read")))
               $display("  [%0t ns] ==WARNING== Dummy clock number is not sufficient for the operating frequency. The memory reads wrong data",$time);
           end

        4 : begin
             
               if(((fO>133) && (cmdRecName=="Read Fast")) ||
                 ((fO>115) && (cmdRecName=="Dual Output Fast Read")) ||
                 ((fO>97) && (cmdRecName=="Dual I/O Fast Read" || cmdRecName=="Dual Command Fast Read" || cmdRecName=="Quad Output Fast Read")) ||
                 ((fO>69) && (cmdRecName=="Quad I/O Fast Read" || cmdRecName=="Quad Command Fast Read")))
               $display("  [%0t ns] ==WARNING== Dummy clock number is not sufficient for the operating frequency. The memory reads wrong data",$time);
           end

        
        5 : begin
             
               if(((fO>133) && (cmdRecName=="Read Fast" || cmdRecName=="Dual Output Fast Read")) ||
                 ((fO>125) && (cmdRecName=="Dual I/O Fast Read" || cmdRecName=="Dual Command Fast Read" || cmdRecName=="Quad Output Fast Read")) ||
                 ((fO>106) && (cmdRecName=="Quad I/O Fast Read" || cmdRecName=="Quad Command Fast Read")))
               $display("  [%0t ns] ==WARNING== Dummy clock number is not sufficient for the operating frequency. The memory reads wrong data",$time);
           end
        
        6 : begin
               if(((fO>133) && (cmdRecName=="Read Fast" || cmdRecName=="Dual Output Fast Read")) ||
                 ((fO>105) && (cmdRecName=="Dual I/O Fast Read" || cmdRecName=="Dual Command Fast Read" || cmdRecName=="Quad Output Fast Read")) ||
                 ((fO>80) && (cmdRecName=="Quad I/O Fast Read" || cmdRecName=="Quad Command Fast Read")))
               $display("  [%0t ns] ==WARNING== Dummy clock number is not sufficient for the operating frequency. The memory reads wrong data",$time);
            end
        
        7 : begin

               if(((fO>108) && (cmdRecName=="Read Fast" || cmdRecName=="Dual Output Fast Read" || cmdRecName=="Dual I/O Fast Read" || cmdRecName=="Dual Command Fast Read" || cmdRecName=="Quad Output Fast Read")) ||
                 ((fO>86) && (cmdRecName=="Quad I/O Fast Read" || cmdRecName=="Quad Command Fast Read")))
               $display("  [%0t ns] ==WARNING== Dummy clock number is not sufficient for the operating frequency. The memory reads wrong data",$time);
            end
        8 : begin
               if(((fO>108) && (cmdRecName=="Read Fast" || cmdRecName=="Dual Output Fast Read" || cmdRecName=="Dual I/O Fast Read" || cmdRecName=="Dual Command Fast Read" || cmdRecName=="Quad Output Fast Read")) ||
                 ((fO>95) && (cmdRecName=="Quad I/O Fast Read" || cmdRecName=="Quad Command Fast Read")))
               $display("  [%0t ns] ==WARNING== Dummy clock number is not sufficient for the operating frequency. The memory reads wrong data",$time);
            end
        9 : begin
               if(((fO>108) && (cmdRecName=="Read Fast" || cmdRecName=="Dual Output Fast Read" || cmdRecName=="Dual I/O Fast Read" || cmdRecName=="Dual Command Fast Read" || cmdRecName=="Quad Output Fast Read")) ||
                 ((fO>105) && (cmdRecName=="Quad I/O Fast Read" || cmdRecName=="Quad Command Fast Read")))
               $display("  [%0t ns] ==WARNING== Dummy clock number is not sufficient for the operating frequency. The memory reads wrong data",$time);
            end
        10 : begin
               if((fO>108) && (cmdRecName=="Read Fast" || cmdRecName=="Dual Output Fast Read" || cmdRecName=="Dual I/O Fast Read" || cmdRecName=="Dual Command Fast Read" || cmdRecName=="Quad Output Fast Read" ||
                 cmdRecName=="Quad I/O Fast Read" || cmdRecName=="Quad Command Fast Read"))
               $display("  [%0t ns] ==WARNING== Dummy clock number is not sufficient for the operating frequency. The memory reads wrong data",$time);
            end
            
        default : begin end
    endcase
end
`else
time CDeltaBy2;
integer fO; //calculated operating frequency upon latching of dummy cycles
always @(dummyLatched) begin
    CDeltaBy2 = timeCheck.C_high - timeCheck.C_low;
    fO = 1000 / (CDeltaBy2 * 2);
    //$display("---fO--- %d @ %0t", fO, $time); 
    case (dummyDimEff)

        1: begin

            if(((fO>90) && (cmdRecName=="Read Fast")) || 
              ((fO>80) &&  (cmdRecName=="Dual Output Fast Read")) ||
              ((fO>50) && (cmdRecName=="Dual I/O Fast Read" || cmdRecName=="Dual Command Fast Read")) ||
              ((fO>43) && (cmdRecName=="Quad Output Fast Read")) ||
              ((fO>30) && (cmdRecName=="Quad I/O Fast Read" || cmdRecName=="Quad Command Fast Read")))
               $display("  [%0t ns]  ==WARNING== Dummy clock number %d is not sufficient for the operating frequency %d. The memory reads wrong data",$time,dummyDimEff,fO);
        
           end

        2: begin

            if(((fO>100) && (cmdRecName=="Read Fast")) ||
              ((fO>90) && (cmdRecName=="Dual Output Fast Read")) ||
              ((fO>70) && (cmdRecName=="Dual I/O Fast Read" || cmdRecName=="Dual Command Fast Read")) ||
              ((fO>60) && (cmdRecName=="Quad Output Fast Read")) ||
              ((fO>40) && (cmdRecName=="Quad I/O Fast Read" || cmdRecName=="Quad Command Fast Read")))
               $display("  [%0t ns] ==WARNING== Dummy clock number %d is not sufficient for the operating frequency %d. The memory reads wrong data",$time,dummyDimEff,fO);
        
           end

        3: begin
             
               if(((fO>108) && (cmdRecName=="Read Fast")) ||
                 ((fO>100) && (cmdRecName=="Dual Output Fast Read")) ||
                 ((fO>80) && (cmdRecName=="Dual I/O Fast Read" || cmdRecName=="Dual Command Fast Read")) || 
                 ((fO>75) && (cmdRecName=="Quad Output Fast Read")) ||
                 ((fO>50) && (cmdRecName=="Quad I/O Fast Read" || cmdRecName=="Quad Command Fast Read")))
               $display("  [%0t ns] ==WARNING== Dummy clock number %d is not sufficient for the operating frequency %d. The memory reads wrong data",$time,dummyDimEff,fO);
           end

        4 : begin
             
               if(((fO>108) && (cmdRecName=="Read Fast")) ||
                 ((fO>105) && (cmdRecName=="Dual Output Fast Read")) ||
                 ((fO>90) && (cmdRecName=="Dual I/O Fast Read" || cmdRecName=="Dual Command Fast Read" || cmdRecName=="Quad Output Fast Read")) ||
                 ((fO>60) && (cmdRecName=="Quad I/O Fast Read" || cmdRecName=="Quad Command Fast Read")))
               $display("  [%0t ns] ==WARNING== Dummy clock number %d is not sufficient for the operating frequency %d. The memory reads wrong data",$time,dummyDimEff,fO);
           end

        
        5 : begin
             
               if(((fO>108) && (cmdRecName=="Read Fast" || cmdRecName=="Dual Output Fast Read")) ||
                 ((fO>100) && (cmdRecName=="Dual I/O Fast Read" || cmdRecName=="Dual Command Fast Read" || cmdRecName=="Quad Output Fast Read")) ||
                 ((fO>70) && (cmdRecName=="Quad I/O Fast Read" || cmdRecName=="Quad Command Fast Read")))
               $display("  [%0t ns] ==WARNING== Dummy clock number %d is not sufficient for the operating frequency %d. The memory reads wrong data",$time,dummyDimEff,fO);
           end
        
        6 : begin
               if(((fO>108) && (cmdRecName=="Read Fast" || cmdRecName=="Dual Output Fast Read")) ||
                 ((fO>105) && (cmdRecName=="Dual I/O Fast Read" || cmdRecName=="Dual Command Fast Read" || cmdRecName=="Quad Output Fast Read")) ||
                 ((fO>80) && (cmdRecName=="Quad I/O Fast Read" || cmdRecName=="Quad Command Fast Read")))
               $display("  [%0t ns] ==WARNING== Dummy clock number %d is not sufficient for the operating frequency %d. The memory reads wrong data",$time,dummyDimEff,fO);
            end
        
        7 : begin

               if(((fO>108) && (cmdRecName=="Read Fast" || cmdRecName=="Dual Output Fast Read" || cmdRecName=="Dual I/O Fast Read" || cmdRecName=="Dual Command Fast Read" || cmdRecName=="Quad Output Fast Read")) ||
                 ((fO>86) && (cmdRecName=="Quad I/O Fast Read" || cmdRecName=="Quad Command Fast Read")))
               $display("  [%0t ns] ==WARNING== Dummy clock number %d is not sufficient for the operating frequency %d. The memory reads wrong data",$time,dummyDimEff,fO);
            end
        8 : begin
               if(((fO>108) && (cmdRecName=="Read Fast" || cmdRecName=="Dual Output Fast Read" || cmdRecName=="Dual I/O Fast Read" || cmdRecName=="Dual Command Fast Read" || cmdRecName=="Quad Output Fast Read")) ||
                 ((fO>95) && (cmdRecName=="Quad I/O Fast Read" || cmdRecName=="Quad Command Fast Read")))
               $display("  [%0t ns] ==WARNING== Dummy clock number %d is not sufficient for the operating frequency %d. The memory reads wrong data",$time,dummyDimEff,fO);
            end
        9 : begin
               if(((fO>108) && (cmdRecName=="Read Fast" || cmdRecName=="Dual Output Fast Read" || cmdRecName=="Dual I/O Fast Read" || cmdRecName=="Dual Command Fast Read" || cmdRecName=="Quad Output Fast Read")) ||
                 ((fO>105) && (cmdRecName=="Quad I/O Fast Read" || cmdRecName=="Quad Command Fast Read")))
               $display("  [%0t ns] ==WARNING== Dummy clock number %d is not sufficient for the operating frequency %d. The memory reads wrong data",$time,dummyDimEff,fO);
            end
        10 : begin
               if((fO>108) && (cmdRecName=="Read Fast" || cmdRecName=="Dual Output Fast Read" || cmdRecName=="Dual I/O Fast Read" || cmdRecName=="Dual Command Fast Read" || cmdRecName=="Quad Output Fast Read" ||
                 cmdRecName=="Quad I/O Fast Read" || cmdRecName=="Quad Command Fast Read"))
               $display("  [%0t ns] ==WARNING== Dummy clock number %d is not sufficient for the operating frequency %d. The memory reads wrong data",$time,dummyDimEff,fO);
            end
            
        default : begin end
    endcase
end
`endif

 `ifdef Stack512Mb
 //------------------------------
 // Calculating device select during stacked die
 // die active indicates the die selected
 //------------------------------
 
 always@(addrLatched) begin
   if((prog.enable_4Byte_address == 1) || (NonVolatileReg.NVCR[0] == 0)) begin
     if(rdeasystacken == addrLatch[addrDim +1: addrDim]) begin
       die_active = 1;
     end
     else begin
       die_active = 0;
     end
   end
   else begin
     if(rdeasystacken == ExtAddReg.EAR[1:0]) begin
       die_active = 1;
     end
     else begin
       die_active = 0;
     end
   end
 end
 
 `endif


//------------------------------
// Commands recognition control
//------------------------------


event codeRecognized, seqRecognized, startCUIdec;








always @(cmdLatched) fork : CP_cmdRecControl

    -> startCUIdec; // i CUI decoders si devono attivare solo dopo
                    // che e' partito il presente processo
                    // NB: l'attivazione dell'evento startCUIdec fa partire i CUIdec
                    // immediatamente (nello stesso delta time in cui si attiva l'evento),
                    // e non nel delta time successivo


    begin : ok
        @(codeRecognized or seqRecognized) 
          disable error;
    end

    ///////////////////////////////////////////////////////  
     // adding to fix the 4 byte address problem
     // if the cmd is 4 byte address,the counter for address
     // is reinitialised to 32 bit. // added  
     ///////////////////////////////////////////////////////
 
    begin
         
         if (cmd == 'h13 || cmd  == 'h0C || cmd == 'h3C || cmd == 'hBC || 
           // cmd == 'h6C ||  cmd == 'h0E ||  cmd == 'h3E || cmd == 'hBE || 
           cmd == 'h6C ||  cmd == 'h0E ||  cmd == 'h39 || cmd == 'hBE || 
           // cmd == 'h6E || cmd == 'hEE || cmd == 'hEC || cmd == 'h10 || 
           cmd == 'h3A || cmd == 'hEE || cmd == 'hEC || cmd == 'h10 ||
           `ifdef MEDT_4READ4D
//               cmd=='hE7 ||
           `endif
           `ifdef MEDT_QIEFP_4byte
               cmd=='h3E ||
           `endif
           `ifdef PP_4byte
               cmd=='h12 ||
           `endif        
           `ifdef SE_4byte 
               cmd=='hDC ||
           `endif     
           `ifdef SSE_4byte 
               cmd=='h21 ||
           `endif     
           `ifdef QIFP_4byte 
               cmd=='h34 ||
           `endif     
           `ifdef QIEFP_38
            //   cmd=='h38 ||
           `endif        
           `ifdef MEDT_DYB_4byte
               cmd=='hE0 || cmd=='hE1 || cmd=='hE2 || cmd=='hE3 ||
           `endif
           cmd=='h11 || cmd=='h27 )
           `ifdef byte_4
           begin
            iAddr = addrDimLatch4 - 1;
           end
            `else
            iAddr = addrDimLatch - 1;
        `endif
          else if(cmd == 'h5A) begin
            iAddr = addrDimLatch - 1;
          end
    end 
     
    ///////////////////////////////////////////////////////    
     

    
    
    begin : error
        #0; 
        #1; //wait until CUI decoders execute recognition process (2 delta time maximum)
            //questo secondo ritardo si puo' anche togliere (perche' il ritardo max e' 1 delta)
            if (busy)  begin 
            $display("[%0t ns] **WARNING** Device is busy. Command not accepted.", $time);
                        end
            `ifdef PowDown
         else if (deep_power_down)
            $display("[%0t ns] **WARNING** Deep power down mode. Command not accepted.", $time);
            `endif 
        else if (!ReadAccessOn || !WriteAccessOn || !PollingAccessOn) 
            $display("[%0t ns] **WARNING** Power up is ongoing. Command not accepted.", $time);    
        else if (!busy)  
                //$display("[%0t ns] **ERROR** Command Not Recognized.", $time);
                $display("[%0t ns] **WARNING** Command Not Recognized. %0h %d %d", $time, cmd, rdeasystacken, rdeasystacken2);
        disable ok;
    end    

join



//------------------------------------
// Power Up, Fast POR & Voltage check
//------------------------------------



//--- Reset internal logic (latching disabled when Vcc<Vcc_wi)

assign Vcc_L1 = (Vcc>=Vcc_wi) ?  1 : 0 ;

always @Vcc_L1 
  if (reset_by_powerOn && Vcc_L1)
    reset_by_powerOn = 0;
  else if (!reset_by_powerOn && !Vcc_L1) 
    reset_by_powerOn = 1;
    


assign Vcc_L2 = (Vcc>=Vcc_min) ?  1 : 0 ;

assign Vcc_L3 = (Vcc >= Vcc_min) ? 0 : 1;


//event checkProtocol;

event checkHoldResetEnable;

event checkAddressMode;

event checkAddressSegment;

event checkDummyClockCycle;

//--- Write access

reg WriteAccessCondition = 0;
reg dummySetByNVCR = 0;


//----------------------------
// Power Up  
//----------------------------


always @Vcc_L2 if(Vcc_L2 && PollingAccessOn==0 && ReadAccessOn==0 && WriteAccessCondition==0) fork : CP_powUp_FullAccess
    
    begin : p1
      $display("[%0t ns] ==INFO== Power up: polling allowed.",$time );
      PollingAccessOn=1;
      
      #full_access_power_up_delay;
      $display("[%0t ns] ==INFO== Power up: device fully accessible.",$time );
      ReadAccessOn=1;
      WriteAccessCondition=1;
      // starting protocol defined by NVCR
      -> checkProtocol; 
      //checking hold_enable defined by NVCR
      -> checkHoldResetEnable;
      -> checkDummyClockCycle;
      //checking address mode
      `ifdef byte_4
      -> checkAddressMode;
      //checking address segment
      -> checkAddressSegment;
      `endif
        prog.disableOperations;
      if (rescue_seq_flag == 1)
          -> power_reset;
      disable p2;
    end 

    begin : p2
      @Vcc_L2 if(!Vcc_L2)
        disable p1;
    end

join    

always @(checkDummyClockCycle) begin
    // if(NonVolatileReg.NVCR[15:12]=='b0000) dummyDimEff=15;
//    if(NonVolatileReg.NVCR[15:12]=='b0000) dummyDimEff=8;
//    else if(NonVolatileReg.NVCR[15:12]=='b1111) dummyDimEff=8;
//    else  dummyDimEff=NonVolatileReg.NVCR[15:12];
        if(NonVolatileReg.NVCR[15:12]=='b0000 || NonVolatileReg.NVCR[15:12]=='b1111) begin
            dummySetByNVCR=0;
            dummyDimEff=8;
        end 
        else begin
            dummySetByNVCR=1;
            dummyDimEff=NonVolatileReg.NVCR[15:12];
        end
end

always @(checkHoldResetEnable) begin

 if (NonVolatileReg.NVCR[4]==1) NVCR_HoldResetEnable=1;
 else NVCR_HoldResetEnable=0;

end

`ifdef byte_4

always @(checkAddressMode) begin

 `ifdef start_in_byte_4   
     prog.enable_4Byte_address=1;
 `else    
 if (NonVolatileReg.NVCR[0]==0)  begin
      prog.enable_4Byte_address=1;
      $display("[%0t ns] ==INFO== 4-byte address mode selected",$time);
 end else begin 
       prog.enable_4Byte_address=0;
       $display("[%0t ns] ==INFO== 3-byte address mode selected",$time);
 end
 `endif

end

//always @(checkAddressSegment) if (prog.enable_4Byte_address==0) begin
always @(checkAddressSegment) begin

 if (NonVolatileReg.NVCR[1]==0) begin
 
    ExtAddReg.EAR[EARvalidDim-1:0]={EARvalidDim{1'b1}};
    if(prog.enable_4Byte_address==0) $display("[%0t ns] ==INFO== Top 128M selected",$time);
 
 end else begin
    
    ExtAddReg.EAR[EARvalidDim-1:0]=0;
    if(prog.enable_4Byte_address==0) $display("[%0t ns] ==INFO== Bottom 128M selected",$time);
    
 end
 
end 

`endif
assign WriteAccessOn =PollingAccessOn && ReadAccessOn && WriteAccessCondition;


always @(checkProtocol) begin
if (NonVolatileReg.NVCR[3]==0) protocol="quad";
      else if (NonVolatileReg.NVCR[2]==0) protocol="dual";
      else if(NonVolatileReg.NVCR[3]==1 && NonVolatileReg.NVCR[2]==1) protocol="extended";
      $display("[%0t ns] ==INFO== Protocol selected is %0s",$time, protocol);
      

 

       case (NonVolatileReg.NVCR[11:9])
       'b000 : begin
                XIP=1;
                protocol="extended";
                cmdRecName="Read Fast";
               end
        
       'b001 : begin 
                 XIP=1;
                 cmdRecName="Dual Output Fast Read"; 
                 protocol="extended";
               end
       'b010 : begin
                 XIP=1;
                 cmdRecName="Dual I/O Fast Read";
                 protocol="dual";
               end
 
       'b011 : begin
                 XIP=1;
                 cmdRecName="Quad Output Read"; 
                 protocol="extended";
               end

       'b100 :  begin
                 XIP=1;
                 cmdRecName="Quad I/O Fast Read"; 
                 protocol="quad";
               end

       'b111: XIP=0;
         default : XIP=0;
       endcase  
       
       `ifdef MEDITERANEO
       DoubleTransferRate = !NonVolatileReg.NVCR[5];
  `endif
      $display("[%0t ps] ==INFO== %0s Transfer Rate selected", $time, (DoubleTransferRate ? "Double" : "Single"));
      
end

// When we exit XIP we should check what protocol we should fall to
always @(checkProtocolAfterXIPexit) begin
    if(VolatileEnhReg.VECR[7] == 0)
        protocol="quad";
    else if(VolatileEnhReg.VECR[6] == 0)
        protocol="dual";
    else if(NonVolatileReg.NVCR[3]==0)
        protocol="quad";
    else if(NonVolatileReg.NVCR[2]==0)
        protocol="dual";
    else if(NonVolatileReg.NVCR[3:2] == 'b11)
        protocol="extended";
    $display("[%0t ns] ==INFO== Protocol selected is %0s",$time, protocol);
end

//`ifdef MEDT_4READ4D
//    always @(checkProtocol) begin
//        if(VolatileReg.VCR[3] == 0)
//        begin
//            XIP=1;
//            cmdRecName="Word Read Quad I/O";
//            protocol="extended";
//        end
//        else
//        begin
//            XIP=0;
//            cmdRecName="Word Read Quad I/O";
//            protocol="extended";
//        end
//    end    
//`endif

//---Dummy clock cycle

always @VolatileReg.VCR begin
    if (VolatileReg.VCR[7:4]=='b0000) dummyDimEff=8;
    else if (VolatileReg.VCR[7:4]=='b1111) dummyDimEff=8;
    else dummyDimEff=VolatileReg.VCR[7:4];

end


//--- Voltage drop (power down)

always @Vcc_L1 if (!Vcc_L1 && (PollingAccessOn|| ReadAccessOn || WriteAccessCondition)) begin : CP_powerDown
    $display("[%0t ns] ==INFO== Voltage below the threshold value: device not accessible.", $time);
    ReadAccessOn=0;
    WriteAccessCondition=0;
    PollingAccessOn=0;
    prog.Suspended=0; //the suspended state is reset  
    
end    




//--- Voltage fault (used during program and erase operations)

event voltageFault; //used in Program and erase dynamic check (see also "CP_voltageCheck" process)

assign VccOk = (Vcc>=Vcc_min && Vcc<=Vcc_max) ?  1 : 0 ;

always @VccOk if (!VccOk) ->voltageFault; //check is active when device is not reset
                                          //(this is a dynamic check used during program and erase operations)
        






//---------------------------------
// Vpp (auxiliary voltage) checks
//---------------------------------

//VPP pin Enhanced Supply Voltage feature not implemented



                   

//-----------------
// Read execution
//-----------------


reg [addrDim-1:0] readAddr;
reg bitOut='hZ;
reg [1:0] firstNVCR = 1;
reg [1:0] firstASP = 1;
reg [1:0] firstPSWORD = 0;

event sendToBus;
event sendToBus_stack;


// values assumed by DQ0 and DQ1, when they are not forced
assign DQ0 = 1'bZ;
assign DQ1 = 1'bZ;


//  DQ1 : release of values assigned with "force statement"
always @(posedge S) begin
        quadMode  = 0; // reset the quadmode on every posedge of S
        `ifdef MEDITERANEO
      //      cmd = 'hFF;
            firstPSWORD = 0;
        `endif    

        #tSHQZ release DQ1; 
        if (protocol=="dual" || read.enable_dual) release Vpp_W_DQ2;
        if (protocol=="quad" || read.enable_quad) begin 
            
                        release Vpp_W_DQ2;
                        `ifdef RESET_pin
                        release RESET_DQ3;
                        `elsif HOLD_pin
                        release HOLD_DQ3;
                        `endif
        end
        if(DoubleTransferRate == 1) release DQ0;

        firstNVCR = 1; // resets to default value
    `ifdef MEDT_ADVANCED_SECTOR
        firstASP = 1;
    `endif

end        
// effect on DQ1 by HOLD signal
`ifdef HOLD_pin
    
    reg temp;
    reg temp1;
    //need to recode this 
//    always @(intHOLD) if(intHOLD===0) begin : CP_HOLD_out_effect 
//        begin : out_effect
//            if(cmdRecName=="Dual Output Fast Read") begin
//            temp = DQ0;
//            temp1 = DQ1;
//            #tHLQZ;
//            disable guardian;
//            release DQ1;
//            release DQ0;
//            @(posedge intHOLD) #tHHQX begin 
//                force DQ1=temp1;
//                force DQ0=temp;
//            end
//            ->Debug.x7;
//            end else begin
//            temp = DQ1;
//            #tHLQZ;
//            disable guardian;
//            release DQ1;
//             @(posedge intHOLD) #tHHQX force DQ1=temp;
//            end
//
//        end  
//
//        begin : guardian 
//            @(posedge intHOLD)
//            ->Debug.x8;
//            disable out_effect;
//        end
//    end //CP_HOLD_out_effect   

    always @(negedge intHOLD) begin : CP_HOLD_out_effect_n
    begin : out_effect_n
        if(cmdRecName=="Dual Output Fast Read") begin
            temp1=DQ1;
            temp=DQ0;
            #tHLQZ;
            disable guardian_n;
           // release DQ1;
           // release DQ0;
        end else begin
            temp = DQ1;
            #tHLQZ;
            disable guardian_n;
        end
    end    
    begin: guardian_n
    end
end

    always @(posedge intHOLD) begin : CP_HOLD_out_effect_p
    begin : out_effect_p
        if(cmdRecName=="Dual Output Fast Read") begin
            force DQ1 = temp1;
            force DQ0 = temp;
        end
    end    
end     

`endif    



// read with DQ1 out bit

always @(negedge C) if(logicOn && protocol=="extended") begin : CP_read
#1;
    singleIO_output(ck_count * ((DoubleTransferRate || ((cmd == 'h0D || cmd == 'h0E) ? 1:0))+1)); // 2*ck_count if DTR and cmd is 0D, O.W. 1*ck_count
end

always @(posedge C) if(logicOn) begin
#1;
    if ((DoubleTransferRate || ((cmd == 'h0D || cmd == 'h0E) ? 1:0)) && protocol=="extended" && dtr_dout_started) begin
	singleIO_output(2*(ck_count -1) + 1);
    end
    if ((DoubleTransferRate || ((cmd == 'h0D || cmd == 'h0E) ? 1:0)) && !dtr_dout_started && latchingMode == "N") begin
	// Difference is caused by fact that in DTR, last instr/addr/data bit is latched on negedge clk, but last dummy bit is latched on posedge clk
	// So, in read instr that do not need dummy cycles, data output starts on the negedge following this posedge clk -> do not increment counter
    end else begin
	//RK ck_count = ck_count + 1; // combined 2 always blks to avoid race conditions
    end
end


reg goReadId = 0;
reg [7:0] dataOut_temp;

task singleIO_output;
input [2:0] bit_count;
begin
  #1;
    // $display("In singleIO_output: ck_count=%h", bit_count, $time);
    if(read.enable==1) begin    
        `ifdef MEDITERANEO
        //if((N25Qxxx.DoubleTransferRate == 1 && ((bit_count == 1 && read.succeedingReads == 0) || (bit_count == 0 && read.succeedingReads == 1)))
        if((N25Qxxx.DoubleTransferRate == 1 && ((bit_count == 0 && read.succeedingReads == 0) || (bit_count == 0 && read.succeedingReads == 1)))
            || (N25Qxxx.DoubleTransferRate == 0 && bit_count == 0)) begin
            read.succeedingReads = 1;
        `else
        if(bit_count==0) begin
        `endif
            readAddr = mem.memAddr;
            mem.readData(dataOut); //read data and increments address
            f.out_info(readAddr, dataOut);
        end
        
        #tCLQX
        bitOut = dataOut[dataDim-1-bit_count];
        -> sendToBus;

    end else if(read.enable_fast==1) begin    
        if(bit_count==0) begin
            readAddr = mem.memAddr;
            mem.readData(dataOut); //read data and increments address
            f.out_info(readAddr, dataOut);
        end
        
        #tCLQX
        bitOut = dataOut[dataDim-1-bit_count];
        -> sendToBus;
    
    end else if (read.enable_rsfdp==1) begin
       
        if(bit_count==0) begin
                readAddr = FlashDiscPar.fdpAddr;
                FlashDiscPar.readData(dataOut); //read data and increments address
                f.out_info(readAddr, dataOut);
        end
          
         #tCLQX
          bitOut = dataOut[dataDim-1-bit_count];
          -> sendToBus;


    end else if (stat.enable_SR_read==1) begin
   //    `ifdef MEDITERANEO
     //   if((bit_count==2 && DoubleTransferRate == 1) || (bit_count==0 && DoubleTransferRate==0)) begin
     //  `else
        if(bit_count==0) begin
     //  `endif
            dataOut = stat.SR;
            f.out_info(readAddr, dataOut);
        end    
       
       #tCLQX
     //  `ifdef MEDITERANEO
     //   if(DoubleTransferRate == 1) begin
     //   bitOut = dataOut[dataDim-1-bit_count-2];
  //  end else 
    //`endif
        bitOut = dataOut[dataDim-1-bit_count];
        -> sendToBus;

     end else if (flag.enable_FSR_read==1) begin
        
        if(bit_count==0) begin

            dataOut = flag.FSR;
            f.out_info(readAddr, dataOut);
        end    
       
       #tCLQX
        bitOut = dataOut[dataDim-1-bit_count];
        -> sendToBus;

     end else if (VolatileReg.enable_VCR_read==1) begin
        
       if(bit_count==0) begin

            dataOut = VolatileReg.VCR;
            f.out_info(readAddr, dataOut);
       end    
       
        #tCLQX
        bitOut = dataOut[dataDim-1-bit_count];
        -> sendToBus;

    // added   to check for PMR register read
     end else if (PMReg.enable_PMR_read==1) begin
        
        if(bit_count==0) begin
            dataOut = PMReg.PMR;
            f.out_info(readAddr, dataOut);
        end    
        
        #tCLQX
        bitOut = dataOut[dataDim-1-bit_count];
        -> sendToBus;

     end else if (flag.enable_FSR_read==1) begin
        
        if(bit_count==0) begin
            dataOut = flag.FSR;
            f.out_info(readAddr, dataOut);
        end    
        
        #tCLQX
        bitOut = dataOut[dataDim-1-bit_count];
        -> sendToBus;    
     end else if (VolatileEnhReg.enable_VECR_read==1) begin
        
       if(bit_count==0) begin

            dataOut = VolatileEnhReg.VECR;
            f.out_info(readAddr, dataOut);
        end    
        
        #tCLQX
        // $display("In VECR Read: dataOut=%h, bitOut=%h ", dataOut, bitOut, $time);
        bitOut = dataOut[dataDim-1-bit_count];
        -> sendToBus;
    

     end else if (NonVolatileReg.enable_NVCR_read==1) begin
     
 
        if(bit_count==0 && firstNVCR == 1) begin
            
            dataOut = NonVolatileReg.NVCR[7:0];
            f.out_info(readAddr, dataOut);
            firstNVCR=0;
          
        end else if(bit_count==0 && firstNVCR == 0) begin
         
           dataOut = NonVolatileReg.NVCR[15:8];
           f.out_info(readAddr, dataOut);
           firstNVCR=2;
        end
        else if(bit_count==0  && firstNVCR == 2)begin
           dataOut = 0;
           f.out_info(readAddr, dataOut);
        end
       
        #tCLQX
        bitOut = dataOut[dataDim-1-bit_count];
        -> sendToBus;

`ifdef MEDT_GPRR
     end else if (GPRR_Reg.enable_GPRR_read==1) begin
        if (bit_count == 0) begin
          if (GPRR_Reg.GPRR_location != 0 && GPRR_Reg.GPRR_location >= 64) begin
            dataOut = 8'h00;
            f.out_info(readAddr, dataOut);
          end else begin   
            dataOut = GPRR_Reg.GPRR[(GPRR_Reg.GPRR_location*8) +: 8];
            f.out_info(readAddr, dataOut);
          end
          if(GPRR_Reg.GPRR_location < 65) begin
            GPRR_Reg.GPRR_location = GPRR_Reg.GPRR_location + 1; 
          end
        end
        #tCLQX
        bitOut = dataOut[dataDim-1-bit_count];
        -> sendToBus;
    `endif        

`ifdef MEDT_PASSWORD
     end else if (PSWORD_Reg.enable_PSWORD_read==1) begin
        if (bit_count == 0 && firstPSWORD == 1) begin
          if(PSWORD_Reg.PSWORD_location < 9) begin
            PSWORD_Reg.PSWORD_location = PSWORD_Reg.PSWORD_location + 1; 
          end
          if (PSWORD_Reg.PSWORD_location != 0 && PSWORD_Reg.PSWORD_location >= 8) begin
            dataOut = 8'h00;
            f.out_info(readAddr, dataOut);
          end else begin   
            dataOut = PSWORD_Reg.PSWORD[(PSWORD_Reg.PSWORD_location*8) +: 8];
            f.out_info(readAddr, dataOut);
          end
          if(ASP_Reg.ASP[2] == 0) dataOut = 'hff;
        end else if(bit_count == 0 && firstPSWORD == 0) begin
          firstPSWORD = 1;
          dataOut = PSWORD_Reg.PSWORD[(PSWORD_Reg.PSWORD_location*8) +: 8];
          f.out_info(readAddr, dataOut);
        end  

        if(PSWORD_Reg.passwordReadNotAllowed==1) begin
            dataOut = 'hzz;
        end

        #tCLQX
        
        bitOut = dataOut[dataDim-1-bit_count];
        -> sendToBus;
    `endif        

`ifdef MEDT_ADVANCED_SECTOR
     end else if (ASP_Reg.enable_ASP_read==1) begin
 
        if(bit_count==0 && firstASP == 1) begin
            
            dataOut = ASP_Reg.ASP[7:0];
            f.out_info(readAddr, dataOut);
            firstASP=0;
          
        end else if(bit_count==0 && firstASP == 0) begin
         
           dataOut = ASP_Reg.ASP[15:8];
           f.out_info(readAddr, dataOut);
           firstASP=2;
        end
        else if(bit_count==0  && firstASP == 2)begin
           dataOut = 0;
           f.out_info(readAddr, dataOut);
        end
       
        #tCLQX
        bitOut = dataOut[dataDim-1-bit_count];
        -> sendToBus;
`endif
 

  `ifdef byte_4

  //modificare 
   end else if (ExtAddReg.enable_EAR_read==1) begin
        
        if(ck_count==0) begin
        
            dataOut = ExtAddReg.EAR[7:0];
            f.out_info(readAddr, dataOut);
            
        end
       
        #tCLQX
        //bitOut = dataOut[dataDim-1-ck_count];
        bitOut = dataOut[dataDim-1-bit_count];
        -> sendToBus;

   `endif   
   `ifdef MEDT_4KBLocking
   end else if (lock.enable_lockReg_read==1 || lock4kb.enable_lockReg_read==1) begin
   `else    
   end else if (lock.enable_lockReg_read==1) begin
   `endif
          if((bit_count==0 && N25Qxxx.DoubleTransferRate==0) ||
             (bit_count==2 && N25Qxxx.DoubleTransferRate==1)) begin 
              readAddr = f.sec(addr);
              `ifdef MEDT_4KBLocking
                  if(readAddr == 'h0 || readAddr == 'h1ff) begin
                      readAddr = f.sub(addr);
                      dataOut = {6'b0, lock4kb.LockReg_LD[readAddr], lock4kb.LockReg_WL[readAddr]};
                      f.out_info(readAddr, dataOut);
                  end else begin
                      dataOut = {6'b0, lock.LockReg_LD[readAddr], lock.LockReg_WL[readAddr]};
                      f.out_info(readAddr, dataOut);
                  end
              `else    
                dataOut = {6'b0, lock.LockReg_LD[readAddr], lock.LockReg_WL[readAddr]};
                f.out_info(readAddr, dataOut);
              `endif 
          end
          
          #tCLQX
          bitOut = dataOut[dataDim-1-bit_count];
          -> sendToBus;

   `ifdef MEDT_PPB 
   end else if (ppb.enable_PPBReg_read == 1) begin
       if(bit_count==0) begin
           readAddr = f.sec(addr);
           if(ppb.PPBReg[readAddr] == 1) dataOut = 8'hff;
           else dataOut = 8'h00;
       end
       #tCLQX
       bitOut = dataOut[dataDim-1-bit_count];
       -> sendToBus;

   end else if (plb.enable_PLBReg_read == 1) begin
       if(bit_count==0) begin
           dataOut = plb.PLB;
           f.out_info(readAddr, dataOut);
       end
       #tCLQX
       bitOut = dataOut[dataDim-1-bit_count];
       -> sendToBus;
   `endif
    
   end else if (read.enable_OTP==1) begin 

          if(bit_count==0) begin
              readAddr = 'h0;
              readAddr = OTP.addr;
              OTP.readData(dataOut); //read data and increments address
              dataOut_temp = dataOut;
              if(readAddr >= 'h40)begin
                  dataOut[0] = OTP.mem[readAddr][0] & PMReg.PMR[3];
                  OTP.addr = 'h40;
              end
              f.out_info(readAddr, dataOut);
          end
          
          if(N25Qxxx.deep_power_down==1) dataOut = 'hzz;
          #tCLQX
          bitOut = dataOut[dataDim-1-bit_count];
          -> sendToBus;

   
   
    end else if (read.enable_ID==1) begin // && protocol=="extended") begin 
        // $display("In READ_ID : bit_count=%h , rdaddr=%h ", bit_count, readAddr, $time);
        `ifdef MEDITERANEO
        if(bit_count==2 && N25Qxxx.DoubleTransferRate == 1 && read.ID_index == 0 ) begin
            goReadId = 1;
        end else if(bit_count==0 && N25Qxxx.DoubleTransferRate == 1 && read.ID_index >= 0) begin
            goReadId = 1;
        end else if (bit_count == 0 && N25Qxxx.DoubleTransferRate == 0) begin
            goReadId = 1;
        end else begin
            goReadId = 0;
        end
        `else
        if(bit_count==0) begin
            goReadId = 1;
        `endif
            if(goReadId == 1) begin //
            readAddr = 'h0;
            readAddr = read.ID_index;
            
            if (read.ID_index==0)      dataOut=Manufacturer_ID;
            else if (read.ID_index==1) dataOut=MemoryType_ID;
            else if (read.ID_index==2) dataOut=MemoryCapacity_ID;
            else if (read.ID_index==3) dataOut=UID;
            else if (read.ID_index==4) dataOut=EDID_0;
            else if (read.ID_index==5) dataOut=EDID_1;
            else if (read.ID_index==6) dataOut=CFD_0;
            else if (read.ID_index==7) dataOut=CFD_1;
            else if (read.ID_index==8) dataOut=CFD_2;
            else if (read.ID_index==9) dataOut=CFD_3;
            else if (read.ID_index==10) dataOut=CFD_4;
            else if (read.ID_index==11) dataOut=CFD_5;
            else if (read.ID_index==12) dataOut=CFD_6;
            else if (read.ID_index==13) dataOut=CFD_7;
            else if (read.ID_index==14) dataOut=CFD_8;
            else if (read.ID_index==15) dataOut=CFD_9;
            else if (read.ID_index==16) dataOut=CFD_10;
            else if (read.ID_index==17) dataOut=CFD_11;
            else if (read.ID_index==18) dataOut=CFD_12;
            else if (read.ID_index==19) dataOut=CFD_13;
            else if (read.ID_index>19) dataOut=0;
            
            //RK if (read.ID_index<=18) read.ID_index=read.ID_index+1;
            if (read.ID_index<=19) read.ID_index=read.ID_index+1;
            //RK else read.ID_index=0;


            f.out_info(readAddr, dataOut);
            `ifndef MEDITERANEO
            end //
        `endif
        end
       
       #tCLQX
        bitOut = dataOut[dataDim-1-bit_count];
        -> sendToBus;

    end   

end


endtask




`ifdef HOLD_pin
//always @(sendToBus or posedge intHOLD) begin
always @(sendToBus) begin
`endif

`ifdef RESET_pin
always @(sendToBus) begin
`endif
    -> sendToBus_stack;
  #0;
  if(die_active == 1 ) begin
    fork : CP_sendToBus


      dtr_dout_started = 1'b1;
      force DQ1 = 1'bX;
      if(N25Qxxx.DoubleTransferRate == 1) force DQ0 = 1'bX;
      if((cmdRecName == "Read Fast") || 
        (cmdRecName == "Dual Command Fast Read") || 
        (cmdRecName == "Quad Command Fast Read") || 
        (cmdRecName == "Dual Output Fast Read") ||
        (cmdRecName == "Dual I/O Fast Read") ||
        (cmdRecName == "Quad I/O Fast Read") 
        ) begin 
      // #(tCLQV - tCLQX) 
        #(tCLQV/2 - tCLQX - 1); 
      end 
      else begin
        #(tCLQV - tCLQX - 1) ;
      end
      // if(DoubleTransferRate == 1) begin
      //   force DQ0 = bitOut;
      // end
      // else begin
        force DQ1 = bitOut;
      // end

    join
  end
end





 event resumeSSEfromHwReset;


//-----------------------
//  Reset Signal
//-----------------------
//dovrebbe essere abilitato attraverso il bit 4 del VECR


event resetEvent; //Activated only in devices with RESET pin.
event SSEresumeHwDone;

reg resetDuringDecoding=0; //These two boolean variables are used in TimingCheck 
reg resetDuringBusy=0;     //entity to check tRHSL timing constraint

    always @reset_by_powerOn if (reset_by_powerOn) begin : PON_reset

        ->resetEvent;
        

        release DQ1; //verificare
        ck_count = 0;
        latchingMode = "N";
        cmd='h0;
        addrLatch='h0;
        addr='h0;
        data='h0;
        dataOut='h0;

        `ifdef byte_4 
            ExtAddReg.EAR = 'b00000000;
            -> checkAddressMode;
            -> checkAddressSegment;
        `endif
        VolatileReg.VCR[7:4] = NonVolatileReg.NVCR[15:12];
        VolatileReg.VCR[3:0] = 'b1011;
        `ifdef MEDITERANEO
        //VolatileEnhReg.VECR[7:5] = 'b111;
        VolatileEnhReg.VECR[7] = NonVolatileReg.NVCR[3];
        VolatileEnhReg.VECR[6] = NonVolatileReg.NVCR[2];
        VolatileEnhReg.VECR[5] = NonVolatileReg.NVCR[5];
        prog.writePass_en = 0;
        `else
        VolatileEnhReg.VECR[7:5] = 'b110;
        `endif
        VolatileEnhReg.VECR[4] = NonVolatileReg.NVCR[4];
        VolatileEnhReg.VECR[3] = 'b1;
        VolatileEnhReg.VECR[2:0] = NonVolatileReg.NVCR[8:6];
        prog.dummySetByVECR = 0;
        prog.dummySetByVCR = 0;
        flag.FSR[7:1] = 'b1000000;
        `ifdef MEDITERANEO
        plb.PLB = 'h01;
        `endif
        iCmd = cmdDim - 1;
        iAddr = addrDimLatch - 1;
        iData = dataDim - 1;
        iDummy = dummyDimEff -1;
        dataLatchedr=0;
        deep_power_down=0;

        if(prog.operation=="Subsector Erase" || prog.operation=="Subsector Erase 32K") begin
            stat.SR[0] = 0; // WIP - write in progress
            stat.SR[1] = 0; // WEL - write enable latch
        end
        // commands waiting to be executed are disabled internally
        
        // read enabler are resetted internally, in the read processes
        
        // CUIdecoders are internally disabled by reset signal
        
        #0 $display("[%0t ns] ==INFO== VCC has been driven below threshold : internal logic will be reset.", $time);
        -> checkProtocol;
        prog.disableOperations;
    end
        
`ifdef RESET_pin 

    always @RESET if (!RESET) begin : CP_reset

        if(prog.subsec_erase_susp == 1) begin
            ->resumeSSEfromHwReset;
            prog.resumedFromHWReset = 1;
            @SSEresumeHwDone;
            end 
        else if(prog.operation =="Subsector Erase" || prog.operation=="Subsector Erase 32K")
            prog.HwResetDuringSSE = 1;

        ->resetEvent;
        
        
        if(S===0 && !busy) 
            resetDuringDecoding=1; 
        else if (busy && prog.operation!="Subsector Erase" && prog.operation!="Subsector Erase 32K")
            resetDuringBusy=1; 
        
        if(prog.operation=="Subsector Erase" || prog.oldOperation=="Subsector Erase" ||
           prog.operation=="Subsector Erase 32K" || prog.oldOperation=="Subsector Erase 32K") @prog.noError2;
        release DQ1; //verificare
        ck_count = 0;
        latchingMode = "N";
        cmd='h0;
        addrLatch='h0;
        addr='h0;
        data='h0;
        dataOut='h0;

        `ifdef byte_4 
            ExtAddReg.EAR = 'b00000000;
            -> checkAddressMode;
            -> checkAddressSegment;
        `endif
        VolatileReg.VCR[7:4] = NonVolatileReg.NVCR[15:12];
        VolatileReg.VCR[3:0] = 'b1011;
        `ifdef MEDITERANEO
        VolatileEnhReg.VECR[7:5] = 'b111;
        prog.writePass_en = 0;
        `else
        VolatileEnhReg.VECR[7:5] = 'b110;
        `endif
        VolatileEnhReg.VECR[4] = NonVolatileReg.NVCR[4];
        VolatileEnhReg.VECR[3] = 'b1;
        VolatileEnhReg.VECR[2:0] = NonVolatileReg.NVCR[8:6];
        prog.dummySetByVECR = 0;
        prog.dummySetByVCR = 0;
        flag.FSR[7:1] = 'b1000000;
        dataLatchedr=0;
        deep_power_down=0;

`ifdef MEDT_GPRR
        GPRR_Reg.GPRR[(64*8)-1:0] = 512'b0;
        //GPRR_Reg.GPRR[7] = 'b1;
`endif

        iCmd = cmdDim - 1;
        iAddr = addrDimLatch - 1;
        iData = dataDim - 1;
        iDummy = dummyDimEff -1;

        if(prog.operation=="Subsector Erase" || prog.operation=="Subsector Erase 32K") begin
            stat.SR[0] = 0; // WIP - write in progress
            stat.SR[1] = 0; // WEL - write enable latch
        end
        // commands waiting to be executed are disabled internally
        
        // read enabler are resetted internally, in the read processes
        
        // CUIdecoders are internally disabled by reset signal
        
        #0 $display("[%0t ns] ==INFO== Reset Signal has been driven low : internal logic will be reset.", $time);
        -> checkProtocol;
        prog.disableOperations;

    end
`ifdef Feature_8
    always @(posedge RESET2) begin
        if(!prog.subsec_erase_susp && prog.operation!="Subsector Erase" && prog.oldOperation!="Subsector Erase")begin 
            -> checkProtocol;
            flag.FSR[7:1] = 'b1000000;
        end
    end
`endif    
`ifdef RESET_pin
    always @(posedge RESET_DQ3) begin
        if(!prog.subsec_erase_susp && prog.operation!="Subsector Erase" && prog.oldOperation!="Subsector Erase")begin 
            -> checkProtocol;
            flag.FSR[7:1] = 'b1000000;
        end
    end
`endif    

`endif    

 event resumeSSEfromSwReset;
 event SSEresumeDone;
`ifdef RESET_software
//-----------------------
// Software Reset 
//-----------------------

   reg  Reset_enable= 0;
    always @(seqRecognized) if (cmdRecName=="Reset Enable") fork : REN 
        
        begin : exe
          @(posedge N25Qxxx.S); 
          disable reset;
          Reset_enable= 1;
          $display("  [%0t ns] Command execution: Reset Enable.", $time);
        end

        begin : reset
          @N25Qxxx.resetEvent;
          disable exe;
        end
    
    join


 always @(seqRecognized) if (cmdRecName=="Reset") begin : SW_reset
        
    if(Reset_enable==1) begin
        if(prog.subsec_erase_susp == 1) begin
            ->resumeSSEfromSwReset;
            prog.resumedFromSWReset = 1;
            @SSEresumeDone;
            end
        else if(prog.operation =="Subsector Erase" || prog.operation == "Subsector Erase 32K")
            prog.SwResetDuringSSE = 1;

        ->resetEvent;
        
        Reset_enable=0;//verificare se va bene
        if(S===0 && !busy) 
            resetDuringDecoding=1; 
        else if (busy)
            resetDuringBusy=1; 
        
        //if(prog.operation=="Subsector Erase" || prog.oldOperation=="Subsector Erase" ||
        //   prog.operation=="Subsector Erase 32K" || prog.oldOperation=="Subsector Erase 32K") @prog.noError2;

        release DQ1; //verificare
        ck_count = 0;
        latchingMode = "N";
        cmd='h0;
        addrLatch='h0;
        addr='h0;
        data='h0;
        dataOut='hff;//Jan3
        
        `ifdef byte_4
            ExtAddReg.EAR = 'b00000000; 
            -> checkAddressMode;
            -> checkAddressSegment;
        `endif
        VolatileReg.VCR[7:4] = NonVolatileReg.NVCR[15:12];
        VolatileReg.VCR[3:0] = 'b1011;
        `ifdef MEDITERANEO
        //VolatileEnhReg.VECR[7:5] = 'b111;
        VolatileEnhReg.VECR[7] = NonVolatileReg.NVCR[3];
        VolatileEnhReg.VECR[6] = NonVolatileReg.NVCR[2];
        VolatileEnhReg.VECR[5] = NonVolatileReg.NVCR[5];
        prog.writePass_en = 0;
        `else
        VolatileEnhReg.VECR[7:5] = 'b110;
        `endif
        VolatileEnhReg.VECR[4] = NonVolatileReg.NVCR[4];
        VolatileEnhReg.VECR[3] = 'b1;
        VolatileEnhReg.VECR[2:0] = NonVolatileReg.NVCR[8:6];
        prog.dummySetByVECR = 0;
        prog.dummySetByVCR = 0;
        //flag.FSR = 'b10000000;
        flag.FSR[7:1] = 'b1000000;
        dataLatchedr=0;
        deep_power_down=0;

`ifdef MEDT_GPRR
        GPRR_Reg.GPRR[(64*8)-1:0] = 512'b0;
        //GPRR_Reg.GPRR[7] = 'b1;
`endif

        iCmd = cmdDim - 1;
        iAddr = addrDimLatch - 1;
        iData = dataDim - 1;
        iDummy =dummyDimEff -1;

        if(prog.operation=="Subsector Erase" || prog.operation=="Subsector Erase 32K") begin
            stat.SR[0] = 0; // WIP - write in progress
            stat.SR[1] = 0; // WEL - write enable latch
        end
        // commands waiting to be executed are disabled internally
        
        // read enabler are resetted internally, in the read processes
        
        // CUIdecoders are internally disabled by reset signal
        
        #0 $display("[%0t ns] ==INFO== Software reset : internal logic will be reset.", $time);
        -> checkProtocol;
        //prog.SR_data = stat.SR;
        prog.disableOperations;

     end else $display("  [%0t ns] **WARNING** A reset-enable command is required before the Reset command: operation aborted!", $time);

 end


always @(seqRecognized) if (cmdRecName!="Reset" && Reset_enable==1) begin 
        Reset_enable=0;
end

`endif
//-----------------------
//  Deep power down 
//-----------------------


`ifdef PowDown


    always @seqRecognized if (cmdRecName=="Deep Power Down") fork : CP_deepPowerDown

        begin : exe
          @(posedge S);
          disable reset;
          if(prog.prog_susp==1) begin
            $display("  [%0t ns] ***WARNING*** - Deep Power Down aborted due to Prog/Erase Suspend",$time);
            disable CP_deepPowerDown;
          end  

          busy=1;
          $display("  [%0t ns] Device is entering in deep power down mode...",$time);
          #deep_power_down_delay;
          $display("  [%0t ns] ...power down mode activated.",$time);
          busy=0;
          deep_power_down=1;
        end

        begin : reset
          @resetEvent;
          disable exe;
        end

    join


    always @seqRecognized if (cmdRecName=="Release Deep Power Down") fork : CP_releaseDeepPowerDown

        begin : exe
          @(posedge S);
          disable reset;
          busy=1;
          $display("  [%0t ns] Release from deep power down is ongoing...",$time);
          #release_power_down_delay;
          $display("  [%0t ns] ...release from power down mode completed.",$time);
          busy=0;
          deep_power_down=0;
        end 

        begin : reset
          @resetEvent;
          disable exe;
        end

    join


`endif


     
//-----------------
//   XIP mode
//-----------------


//-----------------
// Latching address 
//-----------------


always @(negedge S) if (XIP) begin : XIP_latchInit

    $display("[%0t ns] The device is entered in XIP mode.", $time);

    if (protocol=="extended") begin
       if (cmdRecName=="Dual I/O Fast Read" || cmdRecName=="Extended command DIOFRDTR") begin
           latchingMode = "I";
       end else if (cmdRecName=="Quad I/O Fast Read" || cmdRecName=="Extended command QIOFRDTR") begin
           latchingMode = "E";
       `ifdef MEDT_4READ4D    
       end else if (cmdRecName=="Word Read Quad I/O" || cmdRecName=="Word Read Quad Command Fast Read") begin
           latchingMode = "E";
       `endif    
       end else begin
           latchingMode = "A";
       end
       $display("[%0t ns] %0s. Address expected ...", $time,cmdRecName);
            
            fork : XipProc1 

                @(addrLatched) begin
                    
                    $display("  [%0t ns] Address latched: %h (byte %0d of page %0d, sector %0d)", $time, 
                                 addr, f.col(addr), f.pag(addr), f.sec(addr));
                    -> seqRecognized;
                    disable XipProc1;
                end

                @(posedge S) begin
                    $display("  - [%0t ns] S high: command aborted", $time);
                    disable XipProc1;
                end

                @(resetEvent or voltageFault) begin
                    disable XipProc1;
                end
            
            join

    end else  if (protocol=="dual") begin

       latchingMode = "I";
       $display("[%0t ns] %0s. Address expected ...", $time,cmdRecName);
        
              fork : XipProc2 

                @(addrLatched) begin
                     $display("  [%0t ns] Address latched: %h (byte %0d of page %0d, sector %0d)", $time, 
                                 addr, f.col(addr), f.pag(addr), f.sec(addr));
                     -> seqRecognized;
                     disable XipProc2;
                end

                @(posedge S) begin
                    $display("  - [%0t ns] S high: command aborted", $time);
                    disable XipProc2;
                end

                @(resetEvent or voltageFault) begin
                    disable XipProc2;
                end
            
            join

    end else  if (protocol=="quad") begin

       latchingMode = "E";
       $display("[%0t ns]  %0s. Address expected ...", $time,cmdRecName);
        
              fork : XipProc3 

                @(addrLatched) begin
                     $display("  [%0t ns] Address latched: %h (byte %0d of page %0d, sector %0d)", $time, 
                                 addr, f.col(addr), f.pag(addr), f.sec(addr));
                    -> seqRecognized;
                    disable XipProc3;
                end

                @(posedge S) begin
                    $display("  - [%0t ns] S high: command aborted", $time);
                    disable XipProc3;
                end

                @(resetEvent or voltageFault) begin
                    disable XipProc3;
                end
            
            join
    
    end
 
end 

task determineDevName;
    begin
        `ifdef STACKED_MEDT_1G
            $display ("===INFO=== Device Name: %s 1G (2 die stacked) die%d %d",devName,rdeasystacken,rdeasystacken2)    ; 
        `elsif Stack1024Mb
            $display ("===INFO=== Device Name: %s 1G (4 die stacked) die%d %d",devName,rdeasystacken,rdeasystacken2)    ; 
        `elsif Stack512Mb
            $display ("===INFO=== Device Name: %s 512Mb (2 die stacked) die%d %d",devName, rdeasystacken,rdeasystacken2)    ; 
        `else
            $display ("===INFO=== Device Name: %s",devName)    ; 
        `endif

    end
endtask //determineDevName
            



endmodule //N25Qxxx















/*~~~~~~~~~~~~~~~~~~~~~~~~~~~~~~~~~~~~~~~~~~~~~~~~~~~~~~~~~
-----------------------------------------------------------
-----------------------------------------------------------
--                                                       --
--           CUI DECODER                                 --
--                                                       --
-----------------------------------------------------------
-----------------------------------------------------------
~~~~~~~~~~~~~~~~~~~~~~~~~~~~~~~~~~~~~~~~~~~~~~~~~~~~~~~~~*/

`timescale 1ns / 1ps 

module CUIdecoder (cmdAllowed);


    `include "include/DevParam.h" 

    input cmdAllowed;

    parameter [40*8:1] cmdName = "Write Enable";
    parameter [cmdDim-1:0] cmdCode = 'h06;
    parameter withAddr = 1'b0; // 1 -> command with address  /  0 -> without address 
    parameter with2Addr = 1'b0; // 1 -> command with address  /  0 -> without address 
    parameter with4Addr = 1'b0; // 1 -> command with address  /  0 -> without address 
     
    //debug events
    event cui0;
    event cui1;
    event cui2;

    always @N25Qxxx.startCUIdec begin
        -> cui0;
        if (cmdAllowed && cmdCode==N25Qxxx.cmd) begin
        $display("[%0t ns] COMMAND DECODED: %0s , withAddr=%h, with2Addr=%h, with4Addr=%h, cmdcode=%h ", $time, cmdName, withAddr, with2Addr, with4Addr, cmdCode);

        if(!withAddr && !with2Addr && !with4Addr) begin
            
            N25Qxxx.cmdRecName = cmdName;
            $display("[%0t ns] COMMAND RECOGNIZED: %0s.", $time, cmdName);
            -> N25Qxxx.seqRecognized; 
        
        end else if (withAddr) begin
            
            N25Qxxx.quadMode = 0;
            N25Qxxx.latchingMode = "A";
             $display("[%0t ns] 1.COMMAND RECOGNIZED: %0s. Address expected ...", $time, cmdName);
            -> N25Qxxx.codeRecognized;
            
            fork : proc1 

                @(N25Qxxx.addrLatched) begin
                    if (cmdName!="Read OTP" && cmdName!="Program OTP")
                        $display("  [%0t ns] Address latched: %h (byte %0d of page %0d, sector %0d)", $time, 
                                 N25Qxxx.addr, f.col(N25Qxxx.addr), f.pag(N25Qxxx.addr), f.sec(N25Qxxx.addr));
                    else
                        $display("  [%0t ns] Address latched: column %0h", $time, N25Qxxx.addr);
                    N25Qxxx.cmdRecName = cmdName;
                    -> N25Qxxx.seqRecognized;
                    disable proc1;
                end

                @(posedge N25Qxxx.S) begin
                    $display("  - [%0t ns] S high: command aborted", $time);
                    disable proc1;
                end

                @(N25Qxxx.resetEvent or N25Qxxx.voltageFault) begin
                    disable proc1;
                end
            
            join


         end else if (with2Addr) begin
            
            N25Qxxx.quadMode = 0;
            N25Qxxx.latchingMode = "I";
            $display("[%0t ns] 2.COMMAND RECOGNIZED: %0s. Address expected ...", $time, cmdName);
            -> N25Qxxx.codeRecognized;
            
            fork : proc2 

                @(N25Qxxx.addrLatched) begin
                    if (cmdName!="Read OTP" && cmdName!="Program OTP")
                        $display("  [%0t ns] Address latched: %h (byte %0d of page %0d, sector %0d)", $time, 
                                 N25Qxxx.addr, f.col(N25Qxxx.addr), f.pag(N25Qxxx.addr), f.sec(N25Qxxx.addr));
                    else
                        $display("  [%0t ns] Address latched: column %0h cmdName %s", $time, N25Qxxx.addr, cmdName);
                    N25Qxxx.cmdRecName = cmdName;
                    -> N25Qxxx.seqRecognized;
                    disable proc2;
                end

                @(posedge N25Qxxx.S) begin
                    $display("  - [%0t ns] S high: command aborted", $time);
                    disable proc2;
                end

                @(N25Qxxx.resetEvent or N25Qxxx.voltageFault) begin
                    disable proc2;
                end
            join
        end  else if (with4Addr) begin
                    
                                N25Qxxx.quadMode = 1;
                                N25Qxxx.latchingMode = "E";
                                $display("[%0t ns] 4.COMMAND RECOGNIZED: %0s. Address expected ...", $time, cmdName);
                                -> N25Qxxx.codeRecognized;
                                            
                                fork : proc3 
                                   
                                   @(N25Qxxx.addrLatched) begin
                                       if (cmdName!="Read OTP" && cmdName!="Program OTP")
                                           $display("  [%0t ns] Address latched: %h (byte %0d of page %0d, sector %0d)", $time, 
                                           N25Qxxx.addr, f.col(N25Qxxx.addr), f.pag(N25Qxxx.addr), f.sec(N25Qxxx.addr));
                                       else
                                           $display("  [%0t ns] Address latched: column %0h", $time, N25Qxxx.addr);
                                       N25Qxxx.cmdRecName = cmdName;
                                       -> N25Qxxx.seqRecognized;
                                       disable proc3;
                                   end

                                   @(posedge N25Qxxx.S) begin
                                       $display("  - [%0t ns] S high: command aborted", $time);
                                       disable proc3;
                                   end

                                   @(N25Qxxx.resetEvent or N25Qxxx.voltageFault) begin
                                       disable proc3;
                                   end
                                join
      end    
    end
end
endmodule //CUIdecoder    

`ifdef MEDT_MSE
//CUIdecoderEFI captures 
module CUIdecoderEFI_MSE (cmdAllowed);
    `include "include/DevParam.h" 

    input cmdAllowed;

    parameter [40*8:1] cmdName = "Write Enable";
    parameter [cmdDim-1:0] cmdCode1 = 'h9B;
    parameter [cmdDim-1:0] cmdCode2 = 'h26;
    parameter withAddr = 1'b0; // 1 -> command with address  /  0 -> without address 
    parameter with2Addr = 1'b0; // 1 -> command with address  /  0 -> without address 
    parameter with4Addr = 1'b0; // 1 -> command with address  /  0 -> without address 

    reg [cmdDim-1:0] cmd;
    reg [cmdDim-1:0] attr;
    reg [addrDimLatch4 -1 :0] start_address;
    reg [addrDimLatch4 -1 :0] stop_address;
    reg [addrDimLatch4 -1 :0] destAddr;

    integer iCmd2;
    integer iStartAddr;
    integer iStopAddr;

    event abortEFI;
    event efiSeqRecognized; //indicates successfull sequence received
    event efiErrorCheck;
    event efiError; //indicates error in efi (ex. one of ss or s is locked)
    event efiNoError; //

    time mse_delay = 100;

    always @N25Qxxx.startCUIdec begin
        if (cmdAllowed && cmdCode1==N25Qxxx.cmd) begin
            $display("[%0t ns] COMMAND DECODED: %0s , withAddr=%h, with2Addr=%h, with4Addr=%h, cmdcode=%h ", $time, cmdName, withAddr, with2Addr, with4Addr, cmdCode1);
            N25Qxxx.latchingMode="2";
            iCmd2 = cmdDim - 1;
            -> N25Qxxx.codeRecognized;
        end
    end

    // latch sub-opcode
    always @(N25Qxxx.C) if(N25Qxxx.logicOn && N25Qxxx.latchingMode=="2" && N25Qxxx.protocol=="extended") begin : CP_latchCmd2
      `ifdef MEDITERANEO
      if (((N25Qxxx.C==0) && (N25Qxxx.VolatileEnhReg.VECR[5] == 0) && (iCmd2 != 7)) || (N25Qxxx.C == 1)) begin 
      `else
      if (N25Qxxx.C==1) begin  
      `endif

        cmd[iCmd2] = N25Qxxx.DQ0;

        if (iCmd2>0)
            iCmd2 = iCmd2 - 1;
        else if(iCmd2==0) begin
            N25Qxxx.latchingMode = "3";
            iCmd2 = cmdDim;
            $display("[%0t ns] Sub-opcode DECODED: %0s , cmdcode=%h ", $time, cmdName, cmd);
            N25Qxxx.cmdRecName = cmdName;
            if(cmd != cmdCode2) begin
                $display("[%0t ns] Sub-opcode: %h not recognized, aborting operation", $time, cmd);
                -> abortEFI;
            end
        end    
     end        
    end //CP_latchCmd2
    
    //latch attribute (extended)
    always @(N25Qxxx.C) if(N25Qxxx.logicOn && N25Qxxx.latchingMode=="3" && N25Qxxx.protocol=="extended") begin : CP_latchAttr
      `ifdef MEDITERANEO
      if (((N25Qxxx.C==0) && (N25Qxxx.VolatileEnhReg.VECR[5] == 0) && (iCmd2 != 7)) || (N25Qxxx.C == 1)) begin 
      `else
      if (N25Qxxx.C==1) begin  
      `endif

        attr[iCmd2] = N25Qxxx.DQ0;

        if (iCmd2>0)
            iCmd2 = iCmd2 - 1;
        else if(iCmd2==0) begin
            if(attr == 'hFF) begin
                iCmd2 = cmdDim;
                N25Qxxx.latchingMode = "N";
                -> efiSeqRecognized;
                disable disableEFI;
            end else begin
                N25Qxxx.latchingMode = "4";
                iStartAddr = addrDimLatch4;
            end    
            $display("[%0t ns] Attribute Latched: %0h ", $time, attr);
        end    
     end        
    end //CP_latchAttr

    //latch STARTING ADDRESS (extended)
    always @(N25Qxxx.C) if(N25Qxxx.logicOn && N25Qxxx.latchingMode=="4" && N25Qxxx.protocol=="extended") begin : CP_latchStartingAddress
      `ifdef MEDITERANEO
      if (((N25Qxxx.C==0) && (N25Qxxx.VolatileEnhReg.VECR[5] == 0) && (iStartAddr != addrDimLatch4 - 1)) || (N25Qxxx.C == 1)) begin 
      `else
      if (N25Qxxx.C==1) begin  
      `endif

        start_address[iStartAddr] = N25Qxxx.DQ0;

        if (iStartAddr>0)
            iStartAddr = iStartAddr - 1;
        else if(iStartAddr==0) begin
            N25Qxxx.latchingMode = "5";
            iStopAddr = addrDimLatch4;
            $display("[%0t ns] Starting Address Latched: %0h ", $time, start_address);
        end    
     end        
    end //CP_latchStartingAddress

    //latch STOPING ADDRESS (extended)
    always @(N25Qxxx.C) if(N25Qxxx.logicOn && N25Qxxx.latchingMode=="5" && N25Qxxx.protocol=="extended") begin : CP_latchStopingAddress
      `ifdef MEDITERANEO
      if (((N25Qxxx.C==0) && (N25Qxxx.VolatileEnhReg.VECR[5] == 0) && (iStopAddr != addrDimLatch4 - 1)) || (N25Qxxx.C == 1)) begin 
      `else
      if (N25Qxxx.C==1) begin  
      `endif

        stop_address[iStopAddr] = N25Qxxx.DQ0;

        if (iStopAddr>0)
            iStopAddr = iStopAddr - 1;
        else if(iStopAddr==0) begin
            N25Qxxx.latchingMode = "N";
            -> efiSeqRecognized;
            $display("[%0t ns] Stopping Address Latched: %0h ", $time, stop_address);
            disable disableEFI;
        end    
     end        
    end //CP_latchStopingAddress

    always @(N25Qxxx.C) if(N25Qxxx.logicOn && N25Qxxx.latchingMode=="2" && N25Qxxx.protocol=="dual") begin : CP_latchCmd2Dual
      `ifdef MEDITERANEO
      if (((N25Qxxx.C==0) && (N25Qxxx.VolatileEnhReg.VECR[5] == 0) && (iCmd2 != 7)) || (N25Qxxx.C == 1)) begin 
      `else
      if (N25Qxxx.C==1) begin  
      `endif

        cmd[iCmd2] = N25Qxxx.DQ1;
        cmd[iCmd2-1] = N25Qxxx.DQ0;

        if (iCmd2>=3)
            iCmd2 = iCmd2 - 2;
        else if(iCmd2==1) begin
            N25Qxxx.latchingMode = "3";
            iCmd2 = cmdDim +1;
            $display("[%0t ns] Sub-opcode DECODED (dual): %0s , cmdcode=%h ", $time, cmdName, cmd);
            N25Qxxx.cmdRecName = cmdName;
        end    
     end        
    end //CP_latchCmd2Dual

    //latch attribute (dual)
    always @(N25Qxxx.C) if(N25Qxxx.logicOn && N25Qxxx.latchingMode=="3" && N25Qxxx.protocol=="dual") begin : CP_latchAttrDual
      `ifdef MEDITERANEO
      if (((N25Qxxx.C==0) && (N25Qxxx.VolatileEnhReg.VECR[5] == 0) && (iCmd2 != 7)) || (N25Qxxx.C == 1)) begin 
      `else
      if (N25Qxxx.C==1) begin  
      `endif

        attr[iCmd2] = N25Qxxx.DQ1;
        attr[iCmd2-1] = N25Qxxx.DQ0;

        if (iCmd2>=3)
            iCmd2 = iCmd2 - 2;
        else if(iCmd2==1) begin
            N25Qxxx.latchingMode = "4";
            iStartAddr = addrDimLatch4+1;
            $display("[%0t ns] Attribute Latched (dual) : %0h ", $time, attr);
        end    
     end        
    end //CP_latchAttrDual

    //latch STARTING ADDRESS (dual)
    always @(N25Qxxx.C) if(N25Qxxx.logicOn && N25Qxxx.latchingMode=="4" && N25Qxxx.protocol=="dual") begin : CP_latchStartAddrDual
      `ifdef MEDITERANEO
      if (((N25Qxxx.C==0) && (N25Qxxx.VolatileEnhReg.VECR[5] == 0) && (iStartAddr != addrDimLatch4 - 1)) || (N25Qxxx.C == 1)) begin 
      `else
      if (N25Qxxx.C==1) begin  
      `endif

        start_address[iStartAddr] = N25Qxxx.DQ1;
        start_address[iStartAddr-1] = N25Qxxx.DQ0;

        if (iStartAddr>=2)
            iStartAddr = iStartAddr - 2;
        else if(iStartAddr==1) begin
            N25Qxxx.latchingMode = "5";
            iStopAddr = addrDimLatch4+1;
            $display("[%0t ns] Start Address Latched (dual) : %0h ", $time, start_address);
        end    
     end        
    end //CP_latchStartAddrDual

    //latch STOPING ADDRESS (dual)
    always @(N25Qxxx.C) if(N25Qxxx.logicOn && N25Qxxx.latchingMode=="5" && N25Qxxx.protocol=="dual") begin : CP_latchStopAddrDual
      `ifdef MEDITERANEO
      if (((N25Qxxx.C==0) && (N25Qxxx.VolatileEnhReg.VECR[5] == 0) && (iStopAddr != addrDimLatch4 - 1)) || (N25Qxxx.C == 1)) begin 
      `else
      if (N25Qxxx.C==1) begin  
      `endif

        stop_address[iStopAddr] = N25Qxxx.DQ1;
        stop_address[iStopAddr-1] = N25Qxxx.DQ0;

        if (iStopAddr>=3)
            iStopAddr = iStopAddr - 2;
        else if(iStopAddr==1) begin
            N25Qxxx.latchingMode = "N";
            -> efiSeqRecognized;
            $display("[%0t ns] Stop Address Latched (dual) : %0h ", $time, stop_address);
            disable disableEFI;
        end    
     end        
    end //CP_latchStopAddrDual


    always @(N25Qxxx.C) if(N25Qxxx.logicOn && N25Qxxx.latchingMode=="2" && N25Qxxx.protocol=="quad") begin : CP_latchCmd2Quad
      `ifdef MEDITERANEO
      if (((N25Qxxx.C==0) && (N25Qxxx.VolatileEnhReg.VECR[5] == 0) && (iCmd2 != 7)) || (N25Qxxx.C == 1)) begin 
      `else
      if (N25Qxxx.C==1) begin  
      `endif

        `ifdef HOLD_pin
        cmd[iCmd2] = N25Qxxx.HOLD_DQ3;
        `elsif RESET_pin
        cmd[iCmd2] = N25Qxxx.RESET_DQ3;
        `endif
        cmd[iCmd2-1] = N25Qxxx.Vpp_W_DQ2;
        cmd[iCmd2-2] = N25Qxxx.DQ1;
        cmd[iCmd2-3] = N25Qxxx.DQ0;

        if (iCmd2>3)
            iCmd2 = iCmd2 - 4;
        //else if(iCmd2<=0) begin
        else if(iCmd2==3) begin
            N25Qxxx.latchingMode = "3";
            iCmd2 = cmdDim+3;
            $display("[%0t ns] Sub-opcode DECODED: %0s , cmdcode=%h ", $time, cmdName, cmd);
            N25Qxxx.cmdRecName = cmdName;
        end    
     end        
    end //CP_latchCmd2Quad

    //latch attribute (quad)
    always @(N25Qxxx.C) if(N25Qxxx.logicOn && N25Qxxx.latchingMode=="3" && N25Qxxx.protocol=="quad") begin : CP_latchAttrQuad
      `ifdef MEDITERANEO
      if (((N25Qxxx.C==0) && (N25Qxxx.VolatileEnhReg.VECR[5] == 0) && (iCmd2 != 7)) || (N25Qxxx.C == 1)) begin 
      `else
      if (N25Qxxx.C==1) begin  
      `endif

        `ifdef HOLD_pin
        attr[iCmd2] = N25Qxxx.HOLD_DQ3;
        `elsif RESET_pin
        attr[iCmd2] = N25Qxxx.RESET_DQ3;
        `endif
        attr[iCmd2-1] = N25Qxxx.Vpp_W_DQ2;
        attr[iCmd2-2] = N25Qxxx.DQ1;
        attr[iCmd2-3] = N25Qxxx.DQ0;

        if (iCmd2>3)
            iCmd2 = iCmd2 - 4;
        else if(iCmd2==3) begin
            N25Qxxx.latchingMode = "4";
            iStartAddr = addrDimLatch4+3;
            $display("[%0t ns] Attribute Latched: %0h ", $time, attr);
        end    
     end        
    end //CP_latchAttrQuad

    //latch STARTING ADDRESS (quad)
    always @(N25Qxxx.C) if(N25Qxxx.logicOn && N25Qxxx.latchingMode=="4" && N25Qxxx.protocol=="quad") begin : CP_latchStartAddrQuad
      `ifdef MEDITERANEO
      if (((N25Qxxx.C==0) && (N25Qxxx.VolatileEnhReg.VECR[5] == 0) && (iCmd2 != 7)) || (N25Qxxx.C == 1)) begin 
      `else
      if (N25Qxxx.C==1) begin  
      `endif

        `ifdef HOLD_pin
        start_address[iStartAddr] = N25Qxxx.HOLD_DQ3;
        `elsif RESET_pin
        start_address[iStartAddr] = N25Qxxx.RESET_DQ3;
        `endif
        start_address[iStartAddr-1] = N25Qxxx.Vpp_W_DQ2;
        start_address[iStartAddr-2] = N25Qxxx.DQ1;
        start_address[iStartAddr-3] = N25Qxxx.DQ0;

        if (iStartAddr>3)
            iStartAddr = iStartAddr - 4;
        else if(iStartAddr==3) begin
            N25Qxxx.latchingMode = "5";
            iStopAddr = addrDimLatch4+3;
            $display("[%0t ns] Start Address Latched: %0h ", $time, start_address);
        end    
     end        
    end //CP_latchStartAddrQuad

    //latch STOPING ADDRESS (quad)
    always @(N25Qxxx.C) if(N25Qxxx.logicOn && N25Qxxx.latchingMode=="5" && N25Qxxx.protocol=="quad") begin : CP_latchStopAddrQuad
      `ifdef MEDITERANEO
      if (((N25Qxxx.C==0) && (N25Qxxx.VolatileEnhReg.VECR[5] == 0) && (iCmd2 != 7)) || (N25Qxxx.C == 1)) begin 
      `else
      if (N25Qxxx.C==1) begin  
      `endif

        `ifdef HOLD_pin
        stop_address[iStopAddr] = N25Qxxx.HOLD_DQ3;
        `elsif RESET_pin
        stop_address[iStopAddr] = N25Qxxx.RESET_DQ3;
        `endif
        stop_address[iStopAddr-1] = N25Qxxx.Vpp_W_DQ2;
        stop_address[iStopAddr-2] = N25Qxxx.DQ1;
        stop_address[iStopAddr-3] = N25Qxxx.DQ0;

        if (iStopAddr>3)
            iStopAddr = iStopAddr - 4;
        else if(iStopAddr==3) begin
            N25Qxxx.latchingMode = "N";
            -> efiSeqRecognized;
            $display("[%0t ns] Stop Address Latched: %0h ", $time, stop_address);
            disable disableEFI;
        end    
     end        
    end //CP_latchStopAddrQuad


    always @(N25Qxxx.latchingMode or N25Qxxx.S) begin 
        if(N25Qxxx.latchingMode == 2 ||
           N25Qxxx.latchingMode == 3 ||
           N25Qxxx.latchingMode == 4 ||
           N25Qxxx.latchingMode == 5 )
        fork : disableEFI
                @abortEFI begin
                    disable CP_latchCmd2;
                    disable CP_latchAttr;
                    disable CP_latchStartingAddress;
                    disable CP_latchStopingAddress;
                    disable disableEFI;
                end
                @(posedge N25Qxxx.S) begin
                    $display("  - [%0t ns] S high: command aborted", $time);
                    disable CP_latchCmd2;
                    disable CP_latchAttr;
                    disable CP_latchStartingAddress;
                    disable CP_latchStopingAddress;
                    disable disableEFI;
                end
                @(N25Qxxx.resetEvent or N25Qxxx.voltageFault) begin
                    disable CP_latchCmd2;
                    disable CP_latchAttr;
                    disable CP_latchStartingAddress;
                    disable CP_latchStopingAddress;
                    disable disableEFI;
                end
        join
    end

    reg [3:0] ssCount_start; //Subsector count
    reg [3:0] ssCount_stop; //Subsector count
    reg [31:0] ssCount_total;
    reg [8:0] sCount_total;
    //sector address holders for 
    reg [7:0] sector_start_addr;
    reg [7:0] sector_stop_addr;
    reg [3:0] subsector_start_addr;
    reg [3:0] subsector_stop_addr;
    reg [11:0] ss_start_4Kb_address;
    reg [11:0] ss_stop_4Kb_address;
    
    reg [32:0] ssEraseable [0:31]; //[erase me flag][address to be erased]

    reg [7:0] sector_start;
    reg [7:0] sector_stop;
    reg sector_locked_by_V; 
    reg sector_locked_by_NV_b; 
    reg sector_locked_by_SR; 
    reg ssector_locked_by_V;
    integer i;
    integer y;
    integer ss_address_tracker = 0;
    integer init_val;
    integer sector_temp;
    integer ssCount_total_temp;
    integer myTemp;

    always @(efiSeqRecognized) begin
        if(N25Qxxx.cmdRecName == cmdName) 
            fork : MSE_ops
                begin : exe
                    @(posedge N25Qxxx.S)
                    disable reset;
                    N25Qxxx.prog.operation = N25Qxxx.cmdRecName;
                    N25Qxxx.busy = 1;
                    //mse_delay = 1000;
                    $display("  [%0t ns] Command execution begins: %0s.", $time, N25Qxxx.prog.operation);
                    
                    sector_start_addr = start_address[23:16];
                    subsector_start_addr = start_address[15:12];
                    sector_stop_addr = stop_address[23:16];
                    subsector_stop_addr = stop_address[15:12];

                    //4Kb granularity addressing
                    ss_start_4Kb_address = start_address[23:12]; 
                    ss_stop_4Kb_address = stop_address[23:12]; 

                    sector_temp = sector_stop_addr - sector_start_addr;

                    if(start_address > stop_address) begin //not allowed by spec
                        $display("\n [%0t ns] -----ERROR---- Start address > Stop address : %0h > %0h\n", $time, start_address, stop_address);
                        ->efiError;
                    end else if(start_address == stop_address) begin //implies same sector and subsector
                            sCount_total = 0;
                            ssCount_total = 1;
                            checkSubSectorLocksInRange(ssCount_total,start_address);  
                    end else begin //A <= B 
                        //start and stop between top and bottom sectors
                        if(ss_start_4Kb_address > 'hF && ss_stop_4Kb_address < 'hFF0) begin 
                            ssCount_total = ss_start_4Kb_address % 'd16;
                            if(ssCount_total != 0) begin
                                ssCount_total = 'd16 - ssCount_total;
                                ->N25Qxxx.Debug.x0;
                            end else begin
                                sCount_total = 1;
                            end
                            ssCount_total = ssCount_total + ((ss_stop_4Kb_address + 1) % 'd16);
                            sCount_total = sCount_total + sector_temp;
                        //start and stop at bottom or top
                        end else if((ss_start_4Kb_address < 'h10 && ss_stop_4Kb_address < 'h10) ||
                                    (ss_start_4Kb_address > 'hFEF && ss_stop_4Kb_address > 'hFEF)) begin 
                            ssCount_total = (ss_stop_4Kb_address - ss_start_4Kb_address) +1;
                            sCount_total = 0;
                            checkSubSectorLocksInRange(ssCount_total,start_address);  
                            ->N25Qxxx.Debug.x1;
                        //start at bottom and stop anywhere but bottom and top
                        end else if(ss_start_4Kb_address <= 'hF && (ss_stop_4Kb_address > 'hF && ss_stop_4Kb_address < 'hFF0)) begin 
                            ssCount_total = 'd16 - subsector_start_addr; 
                            checkSubSectorLocksInRange(ssCount_total,start_address);  
                            ssCount_total = ssCount_total + ((ss_stop_4Kb_address + 1) % 'd16);
                            checkSubSectorLocksInRange((ss_stop_4Kb_address + 1) %'d16,{ss_stop_4Kb_address,12'h0});  
                            //sCount_total = sector_temp - 'h1;
                            sCount_total = sector_temp ;
                            ->N25Qxxx.Debug.x2;
                        //start anywhere between top and bottom and stop at top
                        end else if((ss_start_4Kb_address > 'hF && ss_start_4Kb_address < 'hFF0) && ss_stop_4Kb_address >= 'hFF0) begin 
                            ssCount_total = subsector_stop_addr + 'h1;
                            checkSubSectorLocksInRange(ssCount_total,{12'hFF0,12'h0});  
                            ssCount_total_temp = ss_start_4Kb_address % 'd16;
                            if(ssCount_total_temp != 0) begin
                                ssCount_total_temp = 'd16 - ssCount_total_temp;
                                checkSubSectorLocksInRange(ssCount_total_temp,{ss_start_4Kb_address,12'h0});  
                                ssCount_total = ssCount_total + ssCount_total_temp;
                                sCount_total = -1;
                            end else begin
                                sCount_total = 1;
                            end
                            sCount_total = sCount_total + sector_temp;
                            ->N25Qxxx.Debug.x3;
                        end else begin //start at bottom while stop at top
                            ssCount_total = 'd16 - subsector_start_addr;
                            checkSubSectorLocksInRange(ssCount_total,start_address);  
                            ssCount_total_temp = subsector_stop_addr + 'h1;
                            checkSubSectorLocksInRange(ssCount_total_temp,{12'hFF0,12'h0});  
                            ssCount_total = ssCount_total + ssCount_total_temp;
                            sCount_total = 'd254;
                            ->N25Qxxx.Debug.x4;
                        end
                    end

                    if(sCount_total != 'd0) begin
                        checkSectorLocksInRange(sCount_total, sector_start_addr);
                    end

                    mse_delay = mseDelay(sCount_total,ssCount_total, erase_delay,erase_ss_delay);

                    -> efiErrorCheck;

                    //-> N25Qxxx.prog.errorCheck;
                    disable N25Qxxx.prog.errorCheck_ops.dynamicCheck.main_ops;

                    @(efiNoError) begin
                        //we do actual erase here
                        if(sCount_total != 'd0) begin
                            eraseSectorsInRange(sCount_total, sector_start_addr);
                        end
                        eraseSubSectorsInRange; 
                        $display("  [%0t ns] Command execution completed: %0s.", $time, N25Qxxx.prog.operation);
                        for(y=0; y<32; y=y+1) begin
                            ssEraseable[y] = 33'h0_0000_0000;
                        end
                    end

                end //exe
                begin : reset
                    @N25Qxxx.resetEvent;
                    N25Qxxx.prog.operation = "None";
                    disable exe;
                end // reset
            join //MSE_ops
    end
    

    always @(efiErrorCheck) fork : efiErrorCheck_ops 
        begin : static_check
            //check if any of the sectors is locked
            if(sCount_total > 0) begin

            end
        end //static_check

        fork : dynamic_check
            @(N25Qxxx.voltageFault) begin
                $display("  [%0t ns] **WARNING** Operation Fault because of Vcc Out of Range!", $time);
                -> efiError; 
            end
            begin
                -> efiNoError;
                #mse_delay;
                resetForMSE;
            end
        join //dynamic_check
    join //efiErrorCheck_ops   
 
    always @(efiError) begin
        //clear ssEraseable
        for(y=0; y<32; y=y+1) begin
            ssEraseable[y] = 33'h0_0000_0000;
        end
        resetForMSE;
        disable MSE_ops;
    end

    function time mseDelay;
        input [31:0] ssC_total;
        input [31:0] sC_total;
        input time erase_delay;
        input time erase_ss_delay;
        integer i;
        begin
             mseDelay = 0;
             for (i = 0; i < sC_total; i=i+1) begin
                 mseDelay = mseDelay + erase_delay;
             end
             for (i = 0; i < ssC_total; i=i+1) begin
                 mseDelay = mseDelay + erase_ss_delay;
             end
        end
    endfunction //mseDelay
    
    task resetForMSE;
        begin
            N25Qxxx.busy = 0;
            //we initialize everything efi
            start_address = 32'h0000_0000; 
            stop_address = 32'h0000_0000; 
            sector_start_addr = 0;
            sector_stop_addr = 0;
            sector_temp = 0;
            subsector_start_addr = 0;
            subsector_start_addr = 0;
            ss_start_4Kb_address = 0;
            ss_stop_4Kb_address = 0;
            sector_start = 0;
            sector_stop  = 0;
            ssCount_stop = 0;
            ssCount_total = 0;
            ssCount_total_temp = 0;
            sCount_total = 0;
            iCmd2 = cmdDim;
            iStartAddr = 0;
            iStopAddr = 0;
            cmd = 0;
            attr = 0;
            mse_delay = 0;
            destAddr = 0;
            ss_address_tracker = 0; 
            disable efiErrorCheck_ops.dynamic_check;
            disable efiErrorCheck_ops;
        end
    endtask //resetForMSE

    task checkSectorLocksInRange;
        input [8:0] nSectors;
        input [7:0] start_address;
        begin
            destAddr = {start_address,16'h0000};
            //for (y=0; y<sCount_total; y=y+1) begin
            for (y=0; y<nSectors; y=y+1) begin
                sector_locked_by_V = N25Qxxx.lock.isProtected_by_lockReg(destAddr);
                sector_locked_by_NV_b = N25Qxxx.ppb.isProtected_by_PPBReg(destAddr);
                sector_locked_by_SR = N25Qxxx.lock.isProtected_by_SR(destAddr);
                if(!sector_locked_by_V && !sector_locked_by_SR && sector_locked_by_NV_b) begin
                    $display("------------DEBUG-------- SUCCESS, Sector not locked %0h %0b %0b\n",destAddr,sector_locked_by_V, sector_locked_by_NV_b, sector_locked_by_SR);
                    destAddr[23:16] = destAddr[23:16] + 1'b1;
                end else begin
                    $display("------------DEBUG-------- FAIL due to locked sector\n");
                    ->efiError;
                end
            end
        end
    endtask //checkSectorLocksInRange
    
    task eraseSectorsInRange;
        input [8:0] nSectors;
        input [7:0] start_address;
        begin
            destAddr = {start_address,16'h0000};
            $display("====DEBUG eraseSectorsInRange \n");
            for (y=0; y<=nSectors-1; y=y+1) begin
                if(destAddr[23:16] != 'h00 && destAddr[23:16] != 'hFF) begin
                    N25Qxxx.mem.eraseSector(destAddr);
                    $display("[INFO] -DEBUG eraseSectorsInRange- %0t Sector %0h is erased %0d\n", $time, destAddr,y);
                end
                destAddr[23:16] = destAddr[23:16] + 1'b1;
            end
        end
    endtask //eraseSectorsInRange
    
    task checkSubSectorLocksInRange;
        input [4:0] nSubSectors;
        input [addrDimLatch4 -1:0] start_address;
        begin
            //$display("We are in checkSubSectorLocksInRange %0d %0h\n", nSubSectors, start_address);
            destAddr = start_address;
            //for (y=init_val;y<(nSubSectors+init_val);y=y+1) begin  
            for (y=0;y<nSubSectors;y=y+1) begin  
                if(destAddr[23:16] == 'h00 || destAddr[23:16] == 'hFF) begin //we only check ss locks when s is at bottom or top sector
                    ssector_locked_by_V = N25Qxxx.lock4kb.isProtected_by_lockReg(destAddr);    
                end else begin
                    ssector_locked_by_V = 0;
                end
                if(!ssector_locked_by_V) begin
                    $display("------------DEBUG-------- SUCCESS Subsector not locked %0h %0b\n",destAddr,ssector_locked_by_V);
                    ssEraseable[ss_address_tracker] = {1'b1,destAddr}; #1;
                    ss_address_tracker = ss_address_tracker + 1;
                    destAddr[15:12] = destAddr[15:12] + 1'b1;
                end else begin
                    $display("------------DEBUG-------- FAIL due to locked sub sector %0h %0b\n", destAddr, ssector_locked_by_V);
                    ->efiError;
                    y = 'h1F; //this terminates the for loop
                end
            end 
        end
    endtask //checkSubSectorLocksInRange
    
    task cacheSSaddressForErase;
        begin
        end
    endtask //cacheSSaddressForErase

    task eraseSubSectorsInRange;
        reg [32:00] temp_addr;
        reg erase_me;
        begin
            //loop through ssErasable, we only erase the address flagged as 1
            for (y=0;y<32;y=y+1) begin  
                //each element of ssEraseable contains the address and the flag
                //that tells the BFM to erase that address.  The flag is needed
                //to be able to erase address 0 or not.
                temp_addr = ssEraseable[y];
                destAddr = temp_addr[31:0];
                erase_me = temp_addr[32];
                if(erase_me == 1'b1) begin
                    N25Qxxx.mem.eraseSubsector(destAddr);
                    $display("[INFO] -DEBUG- %0t 4Kb subsector %0h is erased", $time, destAddr);
                end
            end
        end
    endtask //eraseSubSectorsInRange

endmodule //CUIdecoderEFI_MSE
`endif //MEDT_MSE
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
