merledu/azadi-soc/(commit log)

2023-03-26 Launch azadi-v1.3
    [cover.cfg, waves.dsn, xprop.cfg]
2023-03-26 Add ibex core [RV32IMFC]
    [cover.cfg, xprop.cfg]
2023-07-04 assign the type and the funciotn of the atomic operation to their correct values
    [tluh_sram_adapter.sv]
2023-07-07 fix the increment of the address
    [tluh_sram_adapter.sv]
2023-08-28 small modificatoin in the error signal
    [tluh_sram_adapter.sv]
2023-08-28 Testbench: verify that Intent operation doesn't modify the data in the target device
    [tluh_sram_adapter_tb.sv]
2023-08-28 small change in the req_o signal (don't send req_o in case of internal error) - add some additional testcases
    [tluh_sram_adapter.sv, tluh_sram_adapter_tb.sv]
